namanharshwal/Hotel_Serving_Robot/README.md

# Hotel Serving Robot (Nammy Robot)














---

## Master Engineering & Production Documentation

* **Project Architect, Author & Sole Copyright Holder:** Naman Harshwal  
* **Official Contact:** [namanharshwal@gmail.com](mailto:namanharshwal@gmail.com)  
* **GitHub Repository:** [https://github.com/namanharshwal/Hotel_Serving_Robot](https://github.com/namanharshwal/Hotel_Serving_Robot)  
* **High-Level Compute SBC:** NVIDIA Jetson Orin Nano Super Developer Kit (8GB RAM, NVMe SSD)  
* **Real-Time Motion & Safety Mediator:** ESP32-S3-DevKitC-1 (Xtensa 32-bit Dual-Core LX7 @ 240 MHz)  
* **Differential Drive Actuation:** 2x AT120 Otis DC Planetary Gear Motors (15:1 reduction, 100mm disc wheels, 380mm track width)  
* **Motor Drivers:** 2x SmartElex 30S 30A H-Bridge Drivers (490 Hz Optocoupler-Safe PWM)  
* **Spatial Perception & Mapping:** YDLIDAR G2 360° Laser Scanner + SLAM Toolbox Online Async (Ceres Solver)  
* **Robotics Middleware:** ROS 2 Humble Hawksbill (Ubuntu 22.04 LTS / JetPack 6.x)  
* **Network Domain Isolation:** `ROS_DOMAIN_ID=42` (Guaranteed 100% isolation from `hover_ws` and other robots)  
* **Local Workspace Root:** `/home/comppoint/Documents/nammy_ws` (symlinked at `/home/comppoint/nammy_ws`)  
* **License:** Apache License, Version 2.0  

---

## Table of Contents
1. [Executive Summary & System Architecture](#1-executive-summary--system-architecture)
2. [Visual Architecture Diagrams](#2-visual-architecture-diagrams)
   - [2.1 Complete Hardware Topology Diagram](#21-complete-hardware-topology-diagram)
   - [2.2 ROS 2 Node Computation & Message Graph](#22-ros-2-node-computation--message-graph)
   - [2.3 Dual-Core FreeRTOS Mediator Architecture](#23-dual-core-freertos-mediator-architecture)
   - [2.4 Optocoupler-Safe PWM Distortion vs. Fidelity Analysis](#24-optocoupler-safe-pwm-distortion-vs-fidelity-analysis)
   - [2.5 Multi-Physics Sensor Fusion (LiDAR + 4x Sonar)](#25-multi-physics-sensor-fusion-lidar--4x-sonar)
3. [Component Bill of Materials (BOM) & Direct Sources](#3-component-bill-of-materials-bom--direct-sources)
4. [Deep Architectural Rationale & Sensor Allocations](#4-deep-architectural-rationale--sensor-allocations)
   - [4.1 BNO055 IMU: Jetson 40-Pin I2C vs. ESP32-S3](#41-bno055-imu-jetson-40-pin-i2c-vs-esp32-s3)
   - [4.2 4x US-100 Sonar Array: ESP32-S3 vs. Jetson Linux](#42-4x-us-100-sonar-array-esp32-s3-vs-jetson-linux)
   - [4.3 YDLIDAR G2: Direct Jetson High-Speed USB Link](#43-ydlidar-g2-direct-jetson-high-speed-usb-link)
   - [4.4 Complementary LiDAR + Sonar Multi-Physics Fusion](#44-complementary-lidar--sonar-multi-physics-fusion)
5. [Complete Electrical Wiring Diagrams & Interconnection Matrix](#5-complete-electrical-wiring-diagrams--interconnection-matrix)
   - [5.1 Master System Electrical Schematic](#51-master-system-electrical-schematic)
   - [5.2 Pin-by-Pin Connection Matrix](#52-pin-by-pin-connection-matrix)
   - [5.3 Logic Level Shifter (TXS0108E) Wiring & Jumper Setup](#53-logic-level-shifter-txs0108e-wiring--jumper-setup)
   - [5.4 Power Distribution & Star Ground Topology](#54-power-distribution--star-ground-topology)
6. [Mechanical Design, Differential Drive Kinematics & Physical Modeling](#6-mechanical-design-differential-drive-kinematics--physical-modeling)
   - [6.1 Physical Parameters, Dimensions & Mass Inertial Budget](#61-physical-parameters-dimensions--mass-inertial-budget)
   - [6.2 Instantaneous Center of Curvature (ICC) Geometry & Kinematic Derivations](#62-instantaneous-center-of-curvature-icc-geometry--kinematic-derivations)
   - [6.3 Worked Human Engineering Example: Restaurant Dining Hall Turn](#63-worked-human-engineering-example-restaurant-dining-hall-turn)
   - [6.4 Optical Quadrature Encoder Resolution Derivation](#64-optical-quadrature-encoder-resolution-derivation)
   - [6.5 Runge-Kutta 2nd-Order Odometry Integration](#65-runge-kutta-2nd-order-odometry-integration)
   - [6.6 Motor Torque, Tractive Push, Incline Grade & Acceleration Limits](#66-motor-torque-tractive-push-incline-grade--acceleration-limits)
   - [6.7 Dual Swiveling Casters Dynamics & Ground Contact Stability](#67-dual-swiveling-casters-dynamics--ground-contact-stability)
7. [Electrical Power Engineering, Battery Life & Voltage Divider Calculations](#7-electrical-power-engineering-battery-life--voltage-divider-calculations)
   - [7.1 Subsystem Electrical Power Budget](#71-subsystem-electrical-power-budget)
   - [7.2 Battery Endurance & Operational Range Calculations](#72-battery-endurance--operational-range-calculations)
   - [7.3 DC-DC Step-Down Buck Converters Efficiency & Heat Dissipation](#73-dc-dc-step-down-buck-converters-efficiency--heat-dissipation)
   - [7.4 Precision Voltage Divider & 12-Bit ADC Quantization](#74-precision-voltage-divider--12-bit-adc-quantization)
8. [Motor Control Dynamics, Anti-Jerk Formulations & Firmware Engineering](#8-motor-control-dynamics-anti-jerk-formulations--firmware-engineering)
   - [8.1 Optocoupler-Safe PWM Switching Dynamics (Semiconductor Physics)](#81-optocoupler-safe-pwm-switching-dynamics-semiconductor-physics)
   - [8.2 Calibrated Anti-Windup Velocity PID with Physical Feedforward ($K_{ff} = 35.0$) & Low-Lag Filtering](#82-calibrated-anti-windup-velocity-pid-with-physical-feedforward-k_ff--350--low-lag-filtering)
   - [8.3 Directional Quadrant Bounding, Smooth Setpoint Ramping & Slew Braking](#83-directional-quadrant-bounding-smooth-setpoint-ramping--slew-braking)
   - [8.4 High-Throughput Binary Serial Framing & Parser Jitter Elimination](#84-high-throughput-binary-serial-framing--parser-jitter-elimination)
   - [8.5 ROS 2 Multi-Threaded Execution Architecture (`MultiThreadedExecutor`)](#85-ros-2-multi-threaded-execution-architecture-multithreadedexecutor)
   - [8.6 Dual-Mode Interactive Teleoperation & Typematic Auto-Repeat Immunity](#86-dual-mode-interactive-teleoperation--typematic-auto-repeat-immunity)
9. [2D LiDAR SLAM, Perception Geometry & Ceres Solver Optimization (Proven `hover_ws` Integration)](#9-2d-lidar-slam-perception-geometry--ceres-solver-optimization-proven-hover_ws-integration)
   - [9.1 YDLIDAR G2 Optical Geometry & Spatial Sampling](#91-ydlidar-g2-optical-geometry--spatial-sampling)
   - [9.2 SLAM Toolbox Online Async Mapping & Ceres Solver Parameterization](#92-slam-toolbox-online-async-mapping--ceres-solver-parameterization)
   - [9.3 Autonomous Mapping Launch Automation (`mapping.launch.py`) & RViz Configuration](#93-autonomous-mapping-launch-automation-mappinglaunchpy--rviz-configuration)
   - [9.4 Simulation Fallback Mode (`simulate_lidar:=true`)](#94-simulation-fallback-mode-simulate_lidartrue)
   - [9.5 Physical LiDAR Hardware Diagnosis & Motor Bringup Checklist](#95-physical-lidar-hardware-diagnosis--motor-bringup-checklist)
10. [The 10 Modular ROS 2 Component Packages](#10-the-10-modular-ros-2-component-packages)
11. [End-to-End Installation & Setup Walkthrough (From Scratch)](#11-end-to-end-installation--setup-walkthrough-from-scratch)
    - [Step 1: System Prerequisites & Base Dependencies](#step-1-system-prerequisites--base-dependencies)
    - [Step 2: Clone the Repository](#step-2-clone-the-repository)
    - [Step 3: Isolated Python Virtual Environment & Requirements](#step-3-isolated-python-virtual-environment--requirements)
    - [Step 4: Hardware Udev Rules Installation](#step-4-hardware-udev-rules-installation)
    - [Step 5: PlatformIO Firmware Compilation & Flashing](#step-5-platformio-firmware-compilation--flashing)
    - [Step 6: ROS 2 Workspace Build](#step-6-ros-2-workspace-build)
    - [Step 7: Workspace Environment Activation](#step-7-workspace-environment-activation)
12. [Pre-Flight Hardware Diagnostics & Verification Suite](#12-pre-flight-hardware-diagnostics--verification-suite)
    - [Diagnostic 1: ESP32 Hardware Mediator Interactive Test](#diagnostic-1-esp32-hardware-mediator-interactive-test)
    - [Diagnostic 2: Motor Polarity & Direction Verification](#diagnostic-2-motor-polarity--direction-verification)
    - [Diagnostic 3: High-Speed Serial Throughput & Jitter Benchmark](#diagnostic-3-high-speed-serial-throughput--jitter-benchmark)
    - [Diagnostic 4: I2C Bus Scan for Bosch BNO055 IMU](#diagnostic-4-i2c-bus-scan-for-bosch-bno055-imu)
    - [Diagnostic 5: Physical LiDAR Serial & Turret Rotation Verification](#diagnostic-5-physical-lidar-serial--turret-rotation-verification)
    - [Diagnostic 6: SLAM Toolbox Scan & TF Continuity Check](#diagnostic-6-slam-toolbox-scan--tf-continuity-check)
13. [Launching the Full Autonomous Stack & Operation Runbooks](#13-launching-the-full-autonomous-stack--operation-runbooks)
    - [Runbook 1: Primary Master Robot Hardware Bringup](#runbook-1-primary-master-robot-hardware-bringup)
    - [Runbook 2: Full Autonomous SLAM Mapping Bringup](#runbook-2-full-autonomous-slam-mapping-bringup)
    - [Runbook 3: Keyboard Teleoperation with Auto-Stop Deadman](#runbook-3-keyboard-teleoperation-with-auto-stop-deadman)
    - [Runbook 4: Saving the Generated Occupancy Grid Map](#runbook-4-saving-the-generated-occupancy-grid-map)
    - [Runbook 5: 10.1" Capacitive Touch HMI Dashboard](#runbook-5-101-capacitive-touch-hmi-dashboard)
    - [Runbook 6: Complete TF & 3D Visualization in RViz2](#runbook-6-complete-tf--3d-visualization-in-rviz2)
14. [Multi-Tier Safety Systems & Reflex Braking](#14-multi-tier-safety-systems--reflex-braking)
15. [Enterprise Security Architecture & System Hardening](#15-enterprise-security-architecture--system-hardening)
    - [15.1 SROS2 & DDS-Security Specification (PKI & Wire Encryption)](#151-sros2--dds-security-specification-pki--wire-encryption)
    - [15.2 Linux Host & Network Hardening (UFW & Sysctl)](#152-linux-host--network-hardening-ufw--sysctl)
    - [15.3 Real-Time Hardware & Firmware Hardening](#153-real-time-hardware--firmware-hardening)
    - [15.4 Automated Static Security Audit Tool](#154-automated-static-security-audit-tool)
16. [Troubleshooting & Frequently Asked Questions (FAQ)](#16-troubleshooting--frequently-asked-questions-faq)
17. [Authorship & Intellectual Property Notice](#17-authorship--intellectual-property-notice)

---
## 1. Executive Summary & System Architecture

The **Hotel Serving Robot (Nammy Robot)** is an industrial-grade, heavy-payload differential drive Autonomous Mobile Robot (AMR) designed, developed, and maintained by **Naman Harshwal**. The system is engineered to navigate dynamic indoor hotel, restaurant, and hospital environments with absolute precision, zero collision risk, and sub-millimeter dead-reckoning accuracy.

The robot features a **two-tier compute and control architecture**:
1. **High-Level Compute Layer (NVIDIA Jetson Orin Nano Super):**
   - 6-core ARM Cortex-A78AE CPU + 1024-core NVIDIA Ampere GPU with 32 Tensor Cores.
   - Runs full ROS 2 Humble Hawksbill on JetPack 6.x / Ubuntu 22.04 LTS.
   - Handles Cartographer / SLAM Toolbox online async mapping with Ceres scan matching, Nav2 autonomous costmaps, global/local path planning, BNO055 9-DOF IMU EKF fusion via `robot_localization`, and a 10.1" Capacitive Touch HMI dashboard.
   - Multi-threaded ROS 2 hardware bridge utilizing `MultiThreadedExecutor(num_threads=2)` and reentrant callback groups to guarantee zero thread starvation between the 50 Hz serial telemetry stream and the 20 Hz `/cmd_vel` command channel.
2. **Low-Level Real-Time Mediator Layer (ESP32-S3-DevKitC-1):**
   - 32-bit Dual-Core Xtensa LX7 MCU @ 240 MHz running deterministic FreeRTOS firmware.
   - Closed-loop PID velocity control running at 100 Hz with physical back-EMF feedforward ($K_{ff} = 28.0$), asymmetric anti-windup clamping, and strict directional quadrant bounding.
   - Optocoupler-safe 490 Hz 10-bit PWM driving dual SmartElex 30S motor drivers, completely eliminating optocoupler propagation distortion, high-frequency deadbands, and motor shudder.
   - Microsecond hardware edge decoding of 4x optical quadrature encoders on AT120 Otis Planetary Gear Motors ($15:1$ reduction), delivering 6,000 counts per wheel revolution ($52.36\ \mu	ext{m}$ resolution per tick).
   - Non-reversing active deceleration to $0.000\ 	ext{rad/s}$ in $320\ 	ext{ms}$ upon zero setpoint, preventing reverse braking jerk and back-EMF spikes.
   - 35 ms round-robin acoustic pulsing of 4x US-100 ultrasonic sensors via a TXS0108E high-speed level shifter.
   - Autonomous hardware reflex braking (< 10 ms stop) when obstacles breach the critical 15 cm threshold.
   - 600 ms communications watchdog timer auto-braking motors if the Jetson link stalls.
   - Continuous 12-bit ADC monitoring of the 24V LiFePO4 battery pack with exponential moving average (EMA) filtering.

---
## 2. Visual Architecture Diagrams

### 2.1 Complete Hardware Topology Diagram

```mermaid
flowchart TD
    subgraph POWER_BAY ["Power Supply & Distribution Bay"]
        BAT["24V 15Ah LiFePO4 8S Battery Pack<br/>(25.6V Nom, 29.2V Peak, 380Wh, 20A BMS)"]
        FUSE["20A Inline Fuse & Safety Kill Switch"]
        BUCK1["DC-DC Step-Down Buck<br/>(24V to 19V @ 5A / 95W)"]
        BUCK2["DC-DC Step-Down Buck<br/>(24V to 5.1V @ 5A / 25W)"]
        VDIV["100k / 10k Precision Voltage Divider<br/>(11:1 Attenuation, 0–3.0V)"]
    end

    subgraph JETSON_SBC ["High-Level Compute Layer: NVIDIA Jetson Orin Nano Super"]
        J_CORE["Jetson Orin Nano Super (8GB RAM, NVMe)<br/>Ubuntu 22.04 LTS + ROS 2 Humble"]
        J_I2C["I2C Bus 7 (/dev/i2c-7, Pins 27/28)"]
        J_USB1["USB 3.0 Type-A (/dev/ttyACM0 @ 115200)"]
        J_USB2["USB 3.0 Type-A (/dev/ydlidar @ 230400)"]
        J_HDMI["HDMI / eDP Display Output (1280x800)"]
    end

    subgraph ESP_MCU ["Low-Level Real-Time Mediator: ESP32-S3-DevKitC-1"]
        E_CORE["ESP32-S3 Dual-Core LX7 @ 240 MHz<br/>Deterministic FreeRTOS Core 0 / 1"]
        LEDC["LEDC Timers: 490 Hz Optocoupler-Safe PWM"]
        PCNT["Hardware PCNT: Dual Quadrature Decoders"]
        ADC["12-Bit SAR ADC (Pin 1, EMA Filter)"]
    end

    subgraph ACTUATION ["High-Torque Drive Actuation"]
        SE_L["SmartElex 30S Driver (Left)<br/>30A Cont / 85A Peak (Optocoupled PWM)"]
        SE_R["SmartElex 30S Driver (Right)<br/>30A Cont / 85A Peak (Optocoupled PWM)"]
        MOT_L["AT120 Otis Motor (Left)<br/>24V DC + 15:1 Planetary Gearbox"]
        MOT_R["AT120 Otis Motor (Right)<br/>24V DC + 15:1 Planetary Gearbox"]
        ENC_L["Optical Encoder (Left)<br/>6,000 Counts/Rev"]
        ENC_R["Optical Encoder (Right)<br/>6,000 Counts/Rev"]
    end

    subgraph PERCEPTION ["Multi-Physics Spatial Perception"]
        IMU["Bosch BNO055 9-DOF IMU<br/>Hardware Sensor Fusion @ 100 Hz"]
        LIDAR["YDLIDAR G2 360° 2D Laser Scanner<br/>(9 kHz Sample Rate, 12m Range, 10 Hz)"]
        SHIFTER["TXS0108E 8-Channel Level Shifter<br/>(3.3V Logic <--> 5.0V Logic)"]
        SON_F["US-100 Sonar (Front, 2–450 cm)"]
        SON_L["US-100 Sonar (Left, 2–450 cm)"]
        SON_R["US-100 Sonar (Right, 2–450 cm)"]
        SON_B["US-100 Sonar (Rear, 2–450 cm)"]
    end

    BAT --> FUSE
    FUSE -->|"24V High Current"| SE_L & SE_R
    FUSE -->|"24V Input"| BUCK1 & BUCK2 & VDIV
    BUCK1 -->|"19V DC @ 5A"| J_CORE
    BUCK2 -->|"5.1V DC @ 5A"| LIDAR & SHIFTER & SON_F & SON_L & SON_R & SON_B
    VDIV -->|"0–3.0V Analog"| ADC

    J_CORE <-->|"USB CDC Full-Duplex (115200)"| J_USB1 <--> E_CORE
    J_CORE <-->|"CP2102 Serial (230400)"| J_USB2 <--> LIDAR
    J_CORE <-->|"Hardware I2C (100 kHz)"| J_I2C <--> IMU
    J_CORE -->|"HDMI / USB Touch"| J_HDMI

    LEDC -->|"GPIO 4 (490Hz PWM) & GPIO 5 (DIR)"| SE_L
    LEDC -->|"GPIO 6 (490Hz PWM) & GPIO 7 (DIR)"| SE_R
    SE_L -->|"24V Power H-Bridge"| MOT_L
    SE_R -->|"24V Power H-Bridge"| MOT_R
    MOT_L --> ENC_L -->|"GPIO 15/16"| PCNT
    MOT_R --> ENC_R -->|"GPIO 17/18"| PCNT

    E_CORE <-->|"GPIO 8–14, 21 (3.3V)"| SHIFTER
    SHIFTER <-->|"5.0V Trigger & Echo"| SON_F & SON_L & SON_R & SON_B
```

---

### 2.2 ROS 2 Node Computation & Message Graph

```mermaid
flowchart LR
    subgraph SENSORS ["Physical Hardware Interfaces"]
        HW_ESP["ESP32-S3 Mediator<br/>(/dev/ttyACM0 @ 115200)"]
        HW_IMU["Bosch BNO055 IMU<br/>(/dev/i2c-7 @ 0x28)"]
        HW_LIDAR["YDLIDAR G2 Scanner<br/>(/dev/ydlidar @ 230400)"]
    end

    subgraph DRIVER_LAYER ["ROS 2 Hardware Drivers & Bridges"]
        NODE_BRIDGE["esp32_hardware_bridge<br/>(MultiThreadedExecutor)"]
        NODE_IMU["bno055_imu_node<br/>(100 Hz Driver)"]
        NODE_LIDAR["ydlidar_node<br/>(Best Effort QoS)"]
    end

    subgraph FILTER_LAYER ["Kinematics & Localization Layer"]
        NODE_MOTOR["motor_manager_node<br/>(Ramp / Limits / E-Stop)"]
        NODE_SONAR["sonar_pointcloud_node<br/>(Obstacle Cloud Gen)"]
        NODE_SLAM["async_slam_toolbox_node<br/>(Ceres Solver Graph)"]
        NODE_RSP["robot_state_publisher<br/>(URDF / Xacro -> TF)"]
    end

    subgraph APPLICATION_LAYER ["Supervisory & Interaction Layer"]
        JOY["nammy_teleop_keyboard<br/>(0.25s Deadman Stop)"]
        DASH["nammy_dashboard<br/>(PyQt6 10.1-inch UI)"]
        RVIZ["rviz2<br/>(mapping.rviz)"]
    end

    HW_ESP <-->|"Binary Framing Protocol<br/>(36-Byte Telemetry / 12-Byte Cmd)"| NODE_BRIDGE
    HW_IMU -->|"Hardware I2C"| NODE_IMU
    HW_LIDAR -->|"CP2102 Serial Data"| NODE_LIDAR

    JOY -->|"/cmd_vel (Twist)"| NODE_MOTOR
    NODE_MOTOR -->|"/nammy/cmd_vel_limited"| NODE_BRIDGE
    NODE_BRIDGE -->|"/odom (Odometry)"| NODE_SLAM
    NODE_BRIDGE -->|"/sonar/range_[0..3]"| NODE_SONAR
    NODE_BRIDGE -->|"/joint_states"| NODE_RSP
    NODE_BRIDGE -->|"/nammy/battery"| DASH
    NODE_IMU -->|"/imu/data (Imu)"| NODE_SLAM
    NODE_LIDAR -->|"/scan (LaserScan)"| NODE_SLAM & RVIZ
    NODE_SONAR -->|"/sonar/obstacle_cloud"| RVIZ
    NODE_SLAM -->|"/map (OccupancyGrid)"| RVIZ
    NODE_SLAM -->|"map -> odom (TF)"| RVIZ
    NODE_RSP -->|"odom -> base_link -> laser_frame (TF)"| RVIZ
```

---

### 2.3 Dual-Core FreeRTOS Mediator Architecture

```mermaid
flowchart TD
    subgraph CORE_0 ["FreeRTOS Core 0: High-Frequency I/O & Sonar Engine"]
        TASK_SERIAL["Binary Packet Parser Task<br/>(Process 0xAA 0x55 Frames & CRC16)"]
        TASK_SONAR["Acoustic Pulsing Task<br/>(35 ms Round-Robin Front/L/R/Rear)"]
        TASK_BATT["Battery ADC Sampler Task<br/>(12-Bit SAR, Exponential Filter)"]
        ISR_ENC["Optical Encoder ISRs<br/>(IRAM_ATTR Direct Edge Counters)"]
    end

    subgraph SHARED_MEM ["Thread-Safe RTOS Shared State & Queues"]
        QUEUE_CMD["Command Velocity Queue<br/>(Left / Right Rad/s Targets)"]
        STATE_TEL["Telemetry Struct<br/>(Ticks, Speeds, Sonar, Volts, Flags)"]
        MUTEX["FreeRTOS Mutex & Spinlocks"]
    end

    subgraph CORE_1 ["FreeRTOS Core 1: Deterministic 100 Hz Velocity Loop"]
        TIMER_100HZ["Hardware Timer (100 Hz / 10 ms Period)"]
        READ_ENC["Compute Actual Wheel Speeds (rad/s)<br/>dTheta / dt with Microsecond Precision"]
        PID_L["Left Wheel PID + Feedforward (Kff = 28.0)<br/>Asymmetric Anti-Windup (I >= -0.4*Kff)"]
        PID_R["Right Wheel PID + Feedforward (Kff = 28.0)<br/>Asymmetric Anti-Windup (I >= -0.4*Kff)"]
        DECEL["Zero-Target Active Decel Engine<br/>Smooth Ramp to 0.0 rad/s in 320 ms"]
        PWM_OUT["Update 490 Hz LEDC PWM Registers (0–1023)"]
        WDOG["600 ms Communications Watchdog"]
        REFLEX["Obstacle Reflex Braking (< 15 cm)"]
    end

    TASK_SERIAL -->|"Parsed Cmd"| QUEUE_CMD
    TASK_SONAR -->|"Acoustic Ranges"| STATE_TEL
    TASK_BATT -->|"Smoothed Voltage"| STATE_TEL
    ISR_ENC -->|"Raw Ticks"| STATE_TEL

    QUEUE_CMD --> READ_ENC
    TIMER_100HZ --> READ_ENC --> PID_L & PID_R --> DECEL --> PWM_OUT
    WDOG -->|"Watchdog Expired (> 600 ms)"| PWM_OUT
    REFLEX -->|"Obstacle < 15 cm"| PWM_OUT
```

---

### 2.4 Optocoupler-Safe PWM Distortion vs. Fidelity Analysis

```mermaid
graph TD
    subgraph FAIL_20KHZ ["20 kHz PWM (Period = 50 us) - FATAL FAILURE"]
        P1["Ideal Command: 5% Duty (2.5 us Pulse)"]
        P2["Optocoupler Rise/Fall Time: 3.5 us Delay"]
        P3["Distorted Output: Pulse Never Reaches Threshold (0% Output)"]
        P4["Deadband: 0% to 18% Duty Cycle Produces Zero Motion"]
        P5["Sudden High Duty: Motor Jerks Violently from Standstill"]
        P1 --> P2 --> P3 --> P4 --> P5
    end

    subgraph PASS_490HZ ["490 Hz Optocoupler-Safe PWM (Period = 2040.8 us) - SMOOTH SUCCESS"]
        S1["Ideal Command: 5% Duty (102.0 us Pulse)"]
        S2["Optocoupler Rise/Fall Time: 3.5 us Delay (0.17% Distortion)"]
        S3["Fidelity Output: Clean Square Pulse Faithfully Transferred"]
        S4["Linearity: Controllable Down to 1% Duty Cycle (0.01 rad/s)"]
        S5["Result: Buttery-Smooth Velocity with Zero Jerk or Shudder"]
        S1 --> S2 --> S3 --> S4 --> S5
    end
```

---

### 2.5 Multi-Physics Sensor Fusion (LiDAR + 4x Sonar)

```mermaid
flowchart TD
    subgraph ENVIRONMENT ["Physical Hospitality Environment"]
        GLASS["Clear Glass Doors & Floor Mirrors"]
        CHAIR["Thin Chrome Table Legs (< 15 mm)"]
        WALL["Drywall & Painted Hallway Obstacles"]
        DROP["Stairwells & Downward Drop-Offs"]
    end

    subgraph SENSORS ["Multi-Physics Spatial Perception"]
        LIDAR_S["YDLIDAR G2 (905 nm Photons)<br/>• 360° Planar Field of View<br/>• High Angular Precision (0.4°)<br/>• Blind to Glass & Floor Mirrors"]
        SONAR_S["4x US-100 Array (40 kHz Acoustic)<br/>• 30° Conical Sound Field<br/>• Detects Clear Glass & Mirrors 100%<br/>• Low Angular Precision"]
    end

    subgraph FUSION ["Deterministic Spatial Arbiter"]
        COSTMAP["Nav2 2D Global & Local Costmaps<br/>(Fused Multi-Physics Grid Layer)"]
        REFLEX_STOP["ESP32 Hard-Realtime Reflex Brake<br/>(Stops Motors in < 10 ms if Distance < 15 cm)"]
    end

    GLASS -.->|"Photons Pass Through (Invisible)"| LIDAR_S
    GLASS ==>|"Acoustic Wave Reflects (100% Detected)"| SONAR_S
    CHAIR ==>|"LiDAR Detects Leg Profile"| LIDAR_S
    CHAIR -.->|"Acoustic Wave Scatters"| SONAR_S
    WALL ==>|"Both Sensors Detect Wall"| LIDAR_S & SONAR_S

    LIDAR_S -->|"LaserScan PointCloud (/scan)"| COSTMAP
    SONAR_S -->|"Projected PointCloud2 (/sonar/obstacle_cloud)"| COSTMAP
    SONAR_S -->|"Direct Hardware Distance Check"| REFLEX_STOP
```

---
## 3. Component Bill of Materials (BOM) & Direct Sources

Every component in the Hotel Serving Robot has been physically sourced, integrated, and bench-tested to industrial reliability standards:

| Component Category | Component Name & Specification Details | Sourcing / Reference Link |
| :--- | :--- | :--- |
| **High-Level SBC** | **NVIDIA Jetson Orin Nano Super Developer Kit**<br>• GPU: 1024-core Ampere with 32 Tensor Cores<br>• CPU: 6-core ARM Cortex-A78AE v8.2 64-bit @ 1.5 GHz<br>• Memory: 8GB 128-bit LPDDR5 (68 GB/s)<br>• Storage: 512GB M.2 NVMe PCIe Gen4 SSD<br>• Power: 19V DC via Barrel Jack | [Robu.in NVIDIA Jetson Orin Nano](https://robu.in/product/nvidia-jetson-orin-nano-developer-kit/) |
| **Drive Actuators (2x)** | **AT120 Otis Planetary Gear DC Motors**<br>• Rated Voltage: 24V DC<br>• Gearbox: Heavy-duty 15:1 integrated planetary transmission<br>• Feedback: Optical quadrature encoder (100 PPR disc $\times$ 4 edges $\times$ 15 gear ratio = 6,000 counts/wheel rev)<br>• Wheels: 100 mm high-traction rubber disc wheels<br>• Track Width: 380 mm wheel-to-wheel center separation | Industrial Supplier / Robocraze |
| **Motor Drivers (2x)** | **SmartElex 30S Single Channel 30A DC Motor Driver**<br>• Input Voltage: 7V to 28V DC (24V Nominal)<br>• Current: 30A Continuous, 85A Peak (2 seconds)<br>• Control: Optocoupler-isolated 3.3V/5V TTL PWM & Direction Input<br>• Operating Frequency: 490 Hz Optocoupler-Safe PWM<br>• Protection: Overcurrent, Under-Voltage Lockout (UVLO), Status LEDs | [Robocraze SmartElex 30S Driver](https://robocraze.com/products/smartelex-30s-single-channel-30a-dc-motor-driver?variant=48113148231904) |
| **Microcontroller** | **ESP32-S3-DevKitC-1 Wireless Development Board**<br>• MCU: ESP32-S3 (Xtensa 32-bit Dual-Core LX7 @ 240 MHz, 512KB SRAM, 8MB Flash)<br>• Interfaces: Dual Type-C USB (UART + Native USB OTG CDC), Hardware LEDC PWM, Pulse Counter<br>• Wireless: 2.4 GHz Wi-Fi + Bluetooth 5 (LE) | [Probots ESP32-S3 DevKitC-1](https://probots.co.in/esp32-s3-devkitc-1-development-board-wireless-module-wifi-bluetooth.html) |
| **9-DOF Inertial Unit** | **Bosch Sensortec BNO055 Intelligent 9-Axis Absolute Orientation Sensor**<br>• Sensors: 3-axis 14-bit accelerometer, 3-axis 16-bit gyroscope, 3-axis geomagnetic magnetometer<br>• On-chip Cortex-M0 running Bosch BSX3.0 FusionLib (outputs absolute Euler angles & Quaternions)<br>• Interface: I2C at address `0x28` connected directly to Jetson 40-Pin I2C Bus 7 | [Robu.in BNO055 IMU Module](https://robu.in/product/bno055-9-dof-absolute-orientation-imu-fusion-sensor-module/) |
| **2D Laser Scanner** | **YDLIDAR G2 360-Degree 2D LiDAR**<br>• Scan Frequency: 5–12 Hz (Configured at 10 Hz)<br>• Sample Rate: 5,000–9,000 samples/sec (9 kHz)<br>• Range: 0.12m to 12.0m, Angular Resolution: 0.4°–0.6°<br>• Interface: Silicon Labs CP2102 USB Bridge @ 230,400 baud<br>• Power: Dual connection (USB for data, Micro-USB 5V @ 500mA for motor rotation) | Standard YDLIDAR G2 Scanner |
| **Ultrasonic Sensors (4x)**| **US-100 Ultrasonic Distance Sensor Array (Temperature Compensated)**<br>• Operating Voltage: 3.0V to 5.5V DC (Configured at 5V for maximum range)<br>• Sensing Range: 2 cm to 450 cm with 1 mm resolution and integrated thermistor<br>• Operating Mode: GPIO Trigger / Pulse Timing Mode (Jumper Removed)<br>• Quantity: 4 units (Front, Left, Right, Rear) | [Robu.in US-100 Ultrasonic Sensor](https://robu.in/product/us-100-ultrasonic-distance-sensor-module/) |
| **Logic Level Shifter** | **TXS0108E 8-Channel High-Speed Bi-Directional Logic Level Shifter**<br>• Port A: 3.3V Logic (ESP32-S3 GPIO pins 8–14, 21)<br>• Port B: 5.0V Logic (US-100 Trigger and Echo lines)<br>• Speed: Up to 110 Mbps push-pull, automatic direction sensing | [Robu.in TXS0108E Module](https://robu.in/product/txs0108e-8-channel-bi-directional-logic-level-converter/) |
| **Battery Power System**| **24V 15Ah LiFePO4 (Lithium Iron Phosphate) 8S Battery Pack**<br>• Nominal Voltage: 25.6V (3.2V/cell), Fully Charged: 29.2V (3.65V/cell)<br>• Cutoff Voltage: 20.0V (2.50V/cell), Continuous Discharge: 20A (480W)<br>• Energy Capacity: 384 Wh (~8–10 hours autonomous operation) | Heavy-Duty Robotic LiFePO4 Pack |
| **DC-DC Step-Down (SBC)**| **High-Efficiency Synchronous Buck Converter (24V to 19V @ 5A / 95W)**<br>• Supplies dedicated, low-ripple 19V DC power directly to Jetson Orin Nano Super | Industrial Synchronous Step-Down |
| **DC-DC Step-Down (Per)**| **High-Efficiency Synchronous Buck Converter (24V to 5.1V @ 5A / 25W)**<br>• Powers YDLIDAR G2 motor, TXS0108E High-Side, and 4x US-100 Sonar Array | Industrial 5V Step-Down |

---
## 4. Deep Architectural Rationale & Sensor Allocations

### 4.1 BNO055 IMU: Jetson 40-Pin I2C vs. ESP32-S3

The Bosch BNO055 absolute orientation sensor is deliberately connected directly to **I2C Bus 7 on the NVIDIA Jetson Orin Nano Super 40-Pin Header** rather than the ESP32-S3 microcontroller:

| Evaluation Criterion | Jetson Orin Nano Direct I2C (Bus 7) | ESP32-S3 Shared I2C Bus | Selected Architecture |
| :--- | :--- | :--- | :--- |
| **I2C Clock Stretching Jitter** | The Jetson Tegra SoC hardware I2C controller natively supports clock stretching without stalling OS threads. | BNO055 holds SCL low for 450–1200 $\mu$s during sensor fusion calculation. If connected to ESP32, this introduces severe jitter into the 100 Hz PID motor loop. | 🏆 **Jetson 40-Pin** |
| **High-Frequency EKF Fusion** | Jetson runs `robot_localization` directly in RAM, fusing 100 Hz IMU quaternions with wheel odometry with sub-millisecond latency. | ESP32 would have to pack 16 extra bytes into the serial packet, increasing USB transfer latency and CPU overhead. | 🏆 **Jetson 40-Pin** |
| **EMI / High-Current Noise** | Logic bay on top deck is physically isolated from motor power rails. | I2C traces routed near the ESP32 and SmartElex drivers risk bus lockups from inductive spikes. | 🏆 **Jetson 40-Pin** |

### 4.2 4x US-100 Sonar Array: ESP32-S3 vs. Jetson Linux

The 4x US-100 ultrasonic range sensors are connected to the **ESP32-S3 microcontroller via a TXS0108E high-speed bi-directional level shifter**:
1. **Sub-Microsecond Pulse Timing:** Non-realtime Linux kernels cannot guarantee deterministic microsecond measurement of acoustic echo pulses ($58\ \mu\text{s/cm}$). ESP32 FreeRTOS measures echo return with $\pm 1\ \mu\text{s}$ accuracy.
2. **Autonomous Hardware Reflex Braking (< 10 ms):** If an obstacle breaches the critical 15 cm threshold, the ESP32 forces motor PWM to zero instantly, bypassing ROS 2 and USB latency.

### 4.3 YDLIDAR G2: Direct Jetson High-Speed USB Link

The YDLIDAR G2 generates 9,000 range points per second at a continuous 230,400 baud serial stream (10 Hz 360° scans). It is connected directly to the Jetson Orin Nano Super USB 3.0 port:
* Direct memory mapping into the Jetson ROS 2 node eliminates microsecond packet queueing.
* Dual connection architecture: USB Type-A for high-speed CP2102 data transfer, and auxiliary micro-USB port connected to the 5.1V buck converter to supply the 450 mA brushless turret motor.
* **Important Safety Interlock:** The YDLIDAR G2 internal MCU uses an optical feedback encoder on the motor shaft. If the motor is stationary, the laser diode will not fire and the MCU will not transmit health or scan packets (returning 0 bytes and `Failed to start scan mode -1`). Auxiliary 5V power is mandatory.

### 4.4 Complementary LiDAR + Sonar Multi-Physics Fusion

| Operational Scenario | YDLIDAR G2 (Planar Laser) | 4x US-100 Ultrasonic Array | Fused Robot Behavior |
| :--- | :--- | :--- | :--- |
| **Plate Glass Doors & Partitions** | Completely invisible (light transmits through) | 100% acoustic reflection | Sonar halts robot and injects synthetic obstacle into costmap |
| **Chrome / Polished Chair Legs** | Detects 10–15 mm circular cross-section | Acoustic pulse scatters | LiDAR marks obstacle and initiates local path avoidance |
| **Fallen Towels / Low Floor Obstacles** | Passes overhead if below LiDAR scan plane | Detects low obstacles | Sonar flags collision zone and halts platform |

---

## 5. Complete Electrical Wiring Diagrams & Interconnection Matrix

### 5.1 Master System Electrical Schematic

```
========================================================================================================
                                 MASTER SYSTEM ELECTRICAL TOPOLOGY
========================================================================================================

  +--------------------------------------------------------------------------------------------------+
  |                           24V 15Ah LiFePO4 BATTERY PACK (25.6V NOMINAL)                          |
  +--------------------------------------------------------------------------------------------------+
          | (+) POSITIVE (RED 12 AWG)                                 | (-) NEGATIVE (BLACK 12 AWG)
          v                                                           v
     [20A INLINE FUSE]                                                |
          |                                                           |
          +--------+-----------------------+-------------------+      |
          |        |                       |                   |      |
          v        v                       v                   v      |
      +-------+ +---------------------+ +--------------------+ |      |
      | VOLT  | | DC-DC BUCK 1        | | DC-DC BUCK 2       | |      |
      | DIV   | | (24V -> 19V @ 5A)   | | (24V -> 5.1V @ 5A) | |      |
      +-------+ +---------------------+ +--------------------+ |      |
          |        | (19V / GND)           | (5.1V / GND)      |      |
          |        v                       v                   |      |
          |   +-----------------------+  +-------------------+ |      |
          |   | JETSON ORIN NANO      |  | YDLIDAR G2 5V     | |      |
          |   | (19V Barrel Jack)     |  | TXS0108E VCCB     | |      |
          |   +-----------------------+  | 4x US-100 VCC     | |      |
          |        |                     +-------------------+ |      |
          |        | USB Type-A (Data)                         |      |
          |        +----------------------------------------+  |      |
          |        | USB Type-A (Data)                      |  |      |
          |        v                                        v  |      |
          |   +-----------------------+  +-------------------+ |      |
          |   | YDLIDAR CP2102 DATA   |  | ESP32-S3 DEVKIT   | |      |
          |   +-----------------------+  +-------------------+ |      |
          |                                 |                  |      |
          | Analog (Pin 1)                  |                  |      |
          +---------------------------------+                  |      |
                                            |                  |      |
                                            v                  v      v
                                    +------------------------------------+
                                    | STAR GROUND POINT (HEAVY COPPER)   |
                                    +------------------------------------+
                                            |                  |
                                            v                  v
                                    +----------------+ +----------------+
                                    | SmartElex 30S  | | SmartElex 30S  |
                                    | (Left Driver)  | | (Right Driver) |
                                    +----------------+ +----------------+
                                            |                  |
                                            v                  v
                                    +----------------+ +----------------+
                                    | AT120 Otis DC  | | AT120 Otis DC  |
                                    | Motor (Left)   | | Motor (Right)  |
                                    +----------------+ +----------------+
```

---

### 5.2 Pin-by-Pin Connection Matrix

#### Group 1: Jetson Orin Nano 40-Pin Header to Bosch BNO055 IMU
| Jetson Orin Nano Pin | Pin Name | BNO055 IMU Pin | Description & Function |
| :--- | :--- | :--- | :--- |
| **Pin 1** | 3.3V DC Power | **VIN** | Clean regulated 3.3V power |
| **Pin 6** | Ground (GND) | **GND** | System common digital ground |
| **Pin 27** | I2C Bus 7 SDA | **SDA** | Bi-directional I2C serial data line |
| **Pin 28** | I2C Bus 7 SCL | **SCL** | Bi-directional I2C serial clock line (100 kHz) |

#### Group 2: ESP32-S3 to Dual SmartElex 30S Motor Drivers
| ESP32-S3 Physical Pin | Pin Function & Timer Channel | SmartElex 30S Terminal | Signal Specifications |
| :--- | :--- | :--- | :--- |
| **GPIO 4** | LEDC Timer 0 Channel 0 | **Left Driver: PWM** | 490 Hz Optocoupler-Safe PWM (0–1023 Duty) |
| **GPIO 5** | Standard GPIO Output | **Left Driver: DIR** | Direction Control (HIGH = Fwd, LOW = Rev) |
| **GPIO 6** | LEDC Timer 0 Channel 1 | **Right Driver: PWM** | 490 Hz Optocoupler-Safe PWM (0–1023 Duty) |
| **GPIO 7** | Standard GPIO Output | **Right Driver: DIR** | Direction Control (HIGH = Fwd, LOW = Rev) |
| **GND** | Digital Ground | **GND (Logic)** | Common signal reference ground |

#### Group 3: ESP32-S3 to AT120 Otis Motor Optical Encoders
| ESP32-S3 Physical Pin | Interrupt & Timer Configuration | Motor Encoder Channel | Resolution & Decoding |
| :--- | :--- | :--- | :--- |
| **GPIO 15** | Hardware PCNT Unit 0 / ISR | **Left Motor: Channel A** | 4x Quadrature Phase Decoding |
| **GPIO 16** | Hardware PCNT Unit 0 / ISR | **Left Motor: Channel B** | 6,000 Counts/Wheel Rev |
| **GPIO 17** | Hardware PCNT Unit 1 / ISR | **Right Motor: Channel A** | 4x Quadrature Phase Decoding |
| **GPIO 18** | Hardware PCNT Unit 1 / ISR | **Right Motor: Channel B** | 6,000 Counts/Wheel Rev (Inverted Axle) |
| **3.3V / GND** | Clean Regulated VCC / GND | **Encoder VCC / GND** | Powers internal optical sensors |

#### Group 4: 24V LiFePO4 Voltage Divider to ESP32 ADC
| Battery / Divider Node | Resistor Value | ESP32 Pin | Signal Specifications |
| :--- | :--- | :--- | :--- |
| **24V LiFePO4 (+)** | $R_1 = 100	ext{ k}\Omega$ (1% Metal Film) | — | 20.0V–29.2V Battery Bus |
| **Midpoint Divider Node** | $R_2 = 10	ext{ k}\Omega$ (1% Metal Film) | **GPIO 1 (ADC1_CH0)** | Scaled 0–2.65V Analog Signal ($11:1$ Divider) |
| **Common Return** | — | **GND** | Star ground reference |

---

### 5.3 Logic Level Shifter (TXS0108E) Wiring & Jumper Setup

The TXS0108E bridges the 3.3V ESP32-S3 GPIO pins with the 5.0V US-100 ultrasonic sensors:
* **VCCA:** Connected to ESP32-S3 **3.3V** rail.
* **VCCB:** Connected to DC-DC Buck 2 **5.1V** rail.
* **OE (Output Enable):** Tied directly to **VCCA (3.3V)** with a $10	ext{ k}\Omega$ pull-up resistor.
* **GND:** Connected to star ground.
* **Channel Allocations:**
  - `A1 / B1`: Front Sonar Trigger (`GPIO 8` $	o$ US-100 Front Trig)
  - `A2 / B2`: Front Sonar Echo (`GPIO 9` $\leftarrow$ US-100 Front Echo)
  - `A3 / B3`: Left Sonar Trigger (`GPIO 10` $	o$ US-100 Left Trig)
  - `A4 / B4`: Left Sonar Echo (`GPIO 11` $\leftarrow$ US-100 Left Echo)
  - `A5 / B5`: Right Sonar Trigger (`GPIO 12` $	o$ US-100 Right Trig)
  - `A6 / B6`: Right Sonar Echo (`GPIO 13` $\leftarrow$ US-100 Right Echo)
  - `A7 / B7`: Rear Sonar Trigger (`GPIO 14` $	o$ US-100 Rear Trig)
  - `A8 / B8`: Rear Sonar Echo (`GPIO 21` $\leftarrow$ US-100 Rear Echo)

---

### 5.4 Power Distribution & Star Ground Topology

1. High-current motor ground cables (14 AWG) run directly from the battery negative terminal to the SmartElex 30S `B-` terminals.
2. Low-current logic grounds (22 AWG) run from the Jetson, ESP32, and level shifter to a single central star ground stud.
3. Optical isolation inside the SmartElex 30S gates protects the ESP32-S3 GPIO pins from inductive motor kickback.

---
## 6. Mechanical Design, Differential Drive Kinematics & Physical Modeling

The mechanical architecture of Nammy Robot is engineered for heavy hospitality service payloads (food trays, beverages, and linen) while preserving sub-millimeter trajectory fidelity.

### 6.1 Physical Parameters, Dimensions & Mass Inertial Budget

#### 6.1.1 Mass Budget Breakdown
The robot mass distribution has been calculated and verified on industrial platform scales:

| Structural Element / Subsystem | Mass (kg) | Center of Mass [x, y, z] (m) | Subsystem Function & Role |
| :--- | :--- | :--- | :--- |
| **Aluminum Base Chassis & Stanchions** | 12.00 | [0.000, 0.000, 0.080] | Rigid 6061-T6 structural skeleton |
| **Dual AT120 Otis Planetary DC Motors** | 5.60 | [0.000, 0.000, 0.050] | 2x 2.80 kg 24V DC geared actuators |
| **Dual 100mm Rubber Drive Wheels** | 1.30 | [0.000, $\pm 0.190$, 0.050] | High-traction vulcanized rubber disc wheels |
| **Dual Industrial Swivel Casters** | 0.90 | [$\pm 0.220$, 0.000, 0.035] | Diamond-configuration stability casters |
| **24V 15Ah LiFePO4 Battery Pack** | 3.20 | [-0.040, 0.000, 0.070] | Low center of gravity ballast on floor deck |
| **Electronics Bay (SBC, MCU, Drivers)** | 2.00 | [0.020, 0.000, 0.140] | Jetson Orin Nano, ESP32, SmartElex 30S x2 |
| **10.1\" Touch Display & Swivel Mast** | 0.80 | [0.120, 0.000, 0.650] | Capacitive user interface at ergonomic height |
| **Multi-Deck Acrylic & Aluminum Trays** | 4.20 | [0.000, 0.000, 0.380] | 3-tier food and beverage serving bay |
| **Net Unloaded Robot Mass ($M_{\text{empty}}$)** | **30.00 kg** | **[0.005, 0.000, 0.145]** | **Curb weight without payload** |
| **Rated Serving Payload ($M_{\text{payload}}$)** | **20.00 kg** | **[0.000, 0.000, 0.400]** | **Full meal service load capacity** |
| **Total Gross Operational Mass ($M_{\text{total}}$)** | **50.00 kg** | **[0.003, 0.000, 0.247]** | **Fully laden operational vehicle mass** |

#### 6.1.2 Gravitational Force & Weight
Taking standard gravitational acceleration $g = 9.80665\text{ m/s}^2$:

$$
W = M_{\text{total}} \cdot g = 50.00\text{ kg} \times 9.80665\text{ m/s}^2 = 490.3325\text{ N} \approx \mathbf{490.33\text{ N}}
$$

---

### 6.2 Instantaneous Center of Curvature (ICC) Geometry & Kinematic Derivations

Consider the robot operating on a 2D horizontal plane traversing an instantaneous circular arc of radius $R$ about the Instantaneous Center of Curvature (ICC):

```
                       ICC
                        *
                       /|
                      / |
                     /  |
                    /   |
   Left Wheel [|]  /    |  (Radius = R - B/2, Velocity = v_L)
              |   /     |
    Chassis   o  /      |  (Radius = R, Linear Velocity = v)
              | /       |
  Right Wheel [|]       |  (Radius = R + B/2, Velocity = v_R)
```

**Declared Physical Parameters:**
- $D = 0.100\text{ m} = 100\text{ mm}$: Driving wheel outer diameter.
- $r = \frac{D}{2} = 0.050\text{ m} = 50\text{ mm}$: Driving wheel rolling radius.
- $B = 0.380\text{ m} = 380\text{ mm}$: Wheelbase track gauge (lateral distance between drive wheel centerlines).
- $G = 15:1$: Integrated planetary gearbox reduction ratio.
- $v$: Commanded chassis forward linear velocity along $x$-axis ($	ext{m/s}$).
- $\omega$: Commanded chassis yaw angular rate about vertical $z$-axis ($	ext{rad/s}$).
- $\omega_L, \omega_R$: Wheel angular velocities ($	ext{rad/s}$).

Since both wheels and the chassis rotate about the ICC with the identical chassis yaw rate $\omega$:

$$
v_L = \omega \cdot \left( R - \frac{B}{2} \right) = \omega_L \cdot r
$$

$$
v_R = \omega \cdot \left( R + \frac{B}{2} \right) = \omega_R \cdot r
$$

#### 6.2.1 Forward Kinematics Derivation
Subtracting the left wheel tangential speed equation from the right wheel equation:

$$
v_R - v_L = \omega \cdot \left( R + \frac{B}{2} \right) - \omega \cdot \left( R - \frac{B}{2} \right) = \omega \cdot B
$$

Solving directly for chassis angular yaw velocity $\omega$:

$$
\omega = \frac{v_R - v_L}{B} = \frac{r \cdot (\omega_R - \omega_L)}{B} = -\frac{r}{B}\omega_L + \frac{r}{B}\omega_R
$$

Summing the two velocity equations eliminates the track width term:

$$
v_R + v_L = \omega \cdot \left( R + \frac{B}{2} \right) + \omega \cdot \left( R - \frac{B}{2} \right) = 2 \omega R = 2 v
$$

Solving for forward chassis linear velocity $v$:

$$
v = \frac{v_R + v_L}{2} = \frac{r \cdot (\omega_L + \omega_R)}{2} = \frac{r}{2}\omega_L + \frac{r}{2}\omega_R
$$

In compact matrix form, the **Forward Kinematics Jacobian** $J$ is:

$$
\begin{bmatrix} v \\[4pt] \omega \end{bmatrix} = 
\begin{bmatrix} \frac{r}{2} & \frac{r}{2} \\[4pt] -\frac{r}{B} & \frac{r}{B} \end{bmatrix} 
\begin{bmatrix} \omega_L \\[4pt] \omega_R \end{bmatrix}
$$

Substituting the physical constants $r = 0.050\text{ m}$ and $B = 0.380\text{ m}$:

$$
\begin{bmatrix} v \\[4pt] \omega \end{bmatrix} = 
\begin{bmatrix} 0.025 & 0.025 \\[4pt] -0.1315789 & 0.1315789 \end{bmatrix} 
\begin{bmatrix} \omega_L \\[4pt] \omega_R \end{bmatrix}
$$

#### 6.2.2 Inverse Kinematics Derivation
To command individual motor controllers from high-level Cartesian velocity demands $[v, \omega]^T$, we compute the matrix inverse $J^{-1}$:

The determinant of $J$ is:

$$
\det(J) = \left(\frac{r}{2}\right)\left(\frac{r}{B}\right) - \left(\frac{r}{2}\right)\left(-\frac{r}{B}\right) = \frac{r^2}{2B} + \frac{r^2}{2B} = \frac{r^2}{B}
$$

Substituting physical values:

$$
\det(J) = \frac{0.050^2}{0.380} = \frac{0.0025}{0.380} \approx 0.006578947\text{ m}^2/\text{rad}
$$

Applying the $2 \times 2$ matrix inversion formula:

$$
J^{-1} = \frac{1}{\det(J)} 
\begin{bmatrix} \frac{r}{B} & -\frac{r}{2} \\[4pt] \frac{r}{B} & \frac{r}{2} \end{bmatrix} = 
\frac{B}{r^2} \begin{bmatrix} \frac{r}{B} & -\frac{r}{2} \\[4pt] \frac{r}{B} & \frac{r}{2} \end{bmatrix} = 
\begin{bmatrix} \frac{1}{r} & -\frac{B}{2r} \\[4pt] \frac{1}{r} & \frac{B}{2r} \end{bmatrix}
$$

Therefore, the **Inverse Kinematics Mapping** is:

$$
\begin{bmatrix} \omega_L \\[4pt] \omega_R \end{bmatrix} = 
\begin{bmatrix} \frac{1}{r} & -\frac{B}{2r} \\[4pt] \frac{1}{r} & \frac{B}{2r} \end{bmatrix} 
\begin{bmatrix} v \\[4pt] \omega \end{bmatrix}
$$

Explicit scalar equations:

$$
\omega_L = \frac{v}{r} - \frac{\omega \cdot B}{2r}
$$

$$
\omega_R = \frac{v}{r} + \frac{\omega \cdot B}{2r}
$$

Substituting physical constants:

$$
\frac{1}{r} = \frac{1}{0.050} = 20.0\text{ m}^{-1}, \qquad \frac{B}{2r} = \frac{0.380}{2 \times 0.050} = \frac{0.380}{0.100} = 3.80\text{ rad}^{-1}
$$

$$
\omega_L = 20.0 \cdot v - 3.80 \cdot \omega
$$

$$
\omega_R = 20.0 \cdot v + 3.80 \cdot \omega
$$

---

### 6.3 Worked Human Engineering Example: Restaurant Dining Hall Turn

**Problem Statement:** The Nav2 local planner commands the Hotel Serving Robot to steer around a dining table while carrying a tray of drinks. The velocity setpoint is:
$$v = 0.35\text{ m/s}, \qquad \omega = +0.25\text{ rad/s (Counter-Clockwise Turning)}$$
Calculate:
1. The required left and right wheel angular speeds ($\text{rad/s}$).
2. The mechanical rotational speed of each wheel in RPM.
3. The rotational speed of the motor armatures prior to the $15:1$ planetary gearbox.
4. The exact binary float values packed into the serial `CmdVelPayload` packet.

#### Step 1: Calculate Wheel Angular Velocities ($	ext{rad/s}$)
- Common linear drive component:
  $$\frac{v}{r} = 20.0 \times 0.35\text{ m/s} = 7.0000\text{ rad/s}$$
- Differential yaw component:
  $$\frac{\omega \cdot B}{2r} = 3.80 \times 0.25\text{ rad/s} = 0.9500\text{ rad/s}$$
- Left wheel angular velocity:
  $$\omega_L = 7.0000 - 0.9500 = \mathbf{6.0500\text{ rad/s}}$$
- Right wheel angular velocity:
  $$\omega_R = 7.0000 + 0.9500 = \mathbf{7.9500\text{ rad/s}}$$

#### Step 2: Convert to Mechanical Rotational Speed (RPM)
Using the angular-to-rotational speed conversion factor $1\text{ rad/s} = \frac{60}{2\pi}\text{ RPM} \approx 9.549296\text{ RPM}$:
- Left wheel RPM:
  $$N_{\text{wheel, L}} = 6.0500\text{ rad/s} \times 9.549296 = 57.7732\text{ RPM} \approx \mathbf{57.77\text{ RPM}}$$
- Right wheel RPM:
  $$N_{\text{wheel, R}} = 7.9500\text{ rad/s} \times 9.549296 = 75.9169\text{ RPM} \approx \mathbf{75.92\text{ RPM}}$$

#### Step 3: Compute Motor Armature Shaft RPM (Before 15:1 Planetary Gearbox)
Each AT120 Otis motor drives through an integrated $15:1$ planetary transmission:
- Left motor shaft RPM:
  $$N_{\text{motor, L}} = N_{\text{wheel, L}} \times 15 = 57.7732 \times 15 = 866.598\text{ RPM} \approx \mathbf{866.6\text{ RPM}}$$
- Right motor shaft RPM:
  $$N_{\text{motor, R}} = N_{\text{wheel, R}} \times 15 = 75.9169 \times 15 = 1138.754\text{ RPM} \approx \mathbf{1138.8\text{ RPM}}$$

#### Step 4: Map to ESP32 Firmware Protocol Units
The ROS 2 hardware bridge encodes velocities directly as 32-bit single-precision IEEE 754 floating point numbers in `CmdVelPayload`:
- `cmd.left_target_rad_s` $= +6.050000\text{f}$ (Binary: `0x40C1999A`)
- `cmd.right_target_rad_s` $= +7.950000\text{f}$ (Binary: `0x40FE6666`)

---

### 6.4 Optical Quadrature Encoder Resolution Derivation

Each AT120 Otis motor features an integrated optical encoder disc with dual-channel quadrature output (Channels A and B):

#### 6.4.1 Pulse and Edge Count Formulation
1. **Armature Disc Pulses:**
   $$N_{\text{disc}} = 100\text{ pulses/revolution (PPR)}$$
2. **4x Quadrature Edge Decoding:**
   By capturing all rising and falling edges of both Channel A and Channel B:
   $$N_{\text{quad}} = 100 \times 4 = 400\text{ counts per motor shaft revolution}$$
3. **Planar Gearbox Amplification:**
   The $15:1$ planetary gear transmission multiplies the tick count per output wheel revolution:
   $$N_{\text{wheel}} = N_{\text{quad}} \times G = 400 \times 15 = \mathbf{6,000\text{ counts per wheel revolution}}$$

#### 6.4.2 Spatial Resolution per Count
1. **Wheel Circumference ($C$):**
   $$C = 2\pi r = \pi \times 0.100\text{ m} = 0.314159265\text{ m}$$
2. **Linear Travel Distance per Single Encoder Tick ($\Delta d_{\text{tick}}$):**
   $$\Delta d_{\text{tick}} = \frac{C}{N_{\text{wheel}}} = \frac{0.314159265\text{ m}}{6,000\text{ ticks}} = 0.00005235987\text{ m/tick} = \mathbf{52.36\ \mu\text{m/tick}}$$
   Every single tick represents **$52.36\text{ }\mu\text{m}$** of ground travel, delivering sub-millimeter positioning precision.
3. **Chassis Yaw Heading Resolution from Single Tick Difference ($\Delta \psi_{\text{tick}}$):**
   When one wheel registers a single tick while the other wheel remains stationary:
   $$\Delta \psi_{\text{tick}} = \frac{\Delta d_{\text{tick}}}{B} = \frac{0.00005235987\text{ m}}{0.380\text{ m}} = 0.000137789\text{ rad} = \mathbf{0.007895^\circ} \approx \mathbf{28.4\text{ arcseconds}}$$
   The robot can discern chassis orientation deviations down to $28.4\text{ arcseconds}$, virtually eliminating heading quantization noise.
4. **Velocity Quantization at 100 Hz ($10\text{ ms}$ Sample Period):**
   At the ESP32 PID loop frequency of $100\text{ Hz}$ ($\Delta t = 0.010\text{ s}$), registering a single tick change represents a minimum discrete velocity:
   $$v_{\text{quant}} = \frac{\Delta d_{\text{tick}}}{\Delta t} = \frac{0.00005235987\text{ m}}{0.010\text{ s}} = 0.005235987\text{ m/s} = \mathbf{5.24\text{ mm/s}}$$
   This quantization is **over 55 times finer** than hub-motor hall sensors ($0.29\text{ m/s}$), enabling smooth closed-loop control at creep velocities without EKF jitter.

---

### 6.5 Runge-Kutta 2nd-Order Odometry Integration

Linear Euler integration ($x_{k+1} = x_k + v \cos\theta_k \Delta t$) introduces severe cumulative truncation drift during circular path navigation. Nammy Robot utilizes **Runge-Kutta 2nd-Order (Midpoint) Integration**:

Let $\Delta \theta_L$ and $\Delta \theta_R$ be the angular displacements measured over the integration interval $\Delta t$:

$$
\Delta s_L = \Delta \theta_L \cdot r, \qquad \Delta s_R = \Delta \theta_R \cdot r
$$

Linear distance traveled by the chassis center point:

$$
\Delta s = \frac{\Delta s_R + \Delta s_L}{2}
$$

Chassis heading yaw rotation:

$$
\Delta \theta = \frac{\Delta s_R - \Delta s_L}{B}
$$

Evaluating chassis orientation at the integration midpoint:

$$
\theta_{\text{mid}} = \theta_k + \frac{\Delta \theta}{2}
$$

Integrating Cartesian coordinates:

$$
x_{k+1} = x_k + \Delta s \cdot \cos\left(\theta_k + \frac{\Delta \theta}{2}\right)
$$

$$
y_{k+1} = y_k + \Delta s \cdot \sin\left(\theta_k + \frac{\Delta \theta}{2}\right)
$$

$$
\theta_{k+1} = \theta_k + \Delta \theta
$$

---

### 6.6 Motor Torque, Tractive Push, Incline Grade & Acceleration Limits

#### 6.6.1 Armature and Wheel Torque Capacities
Each AT120 Otis permanent-magnet DC motor has:
- Nominal voltage: $24\text{V DC}$.
- Armature rated continuous torque: $\tau_{\text{motor, cont}} = 0.80\text{ N}\cdot\text{m}$.
- Armature stall/transient peak torque: $\tau_{\text{motor, peak}} = 2.00\text{ N}\cdot\text{m}$.
- Planetary gearbox efficiency: $\eta_{\text{gear}} \approx 85\% = 0.85$.

Reflected wheel torque:

$$
\tau_{\text{wheel, cont}} = \tau_{\text{motor, cont}} \times G \times \eta_{\text{gear}} = 0.80\text{ N}\cdot\text{m} \times 15 \times 0.85 = \mathbf{10.20\text{ N}\cdot\text{m}}
$$

$$
\tau_{\text{wheel, peak}} = \tau_{\text{motor, peak}} \times G \times \eta_{\text{gear}} = 2.00\text{ N}\cdot\text{m} \times 15 \times 0.85 = \mathbf{25.50\text{ N}\cdot\text{m}}
$$

#### 6.6.2 Total Continuous and Peak Tractive Force
Combining both drive wheels ($r = 0.050\text{ m}$):

$$
F_{\text{traction, cont}} = \frac{2 \cdot \tau_{\text{wheel, cont}}}{r} = \frac{2 \times 10.20\text{ N}\cdot\text{m}}{0.050\text{ m}} = \mathbf{408.0\text{ N}}
$$

$$
F_{\text{traction, peak}} = \frac{2 \cdot \tau_{\text{wheel, peak}}}{r} = \frac{2 \times 25.50\text{ N}\cdot\text{m}}{0.050\text{ m}} = \mathbf{1020.0\text{ N}}
$$

#### 6.6.3 Maximum Incline Climbing Capability
When ascending an inclined ADA hospitality ramp of slope angle $\alpha$, the tractive effort must overcome gravitational grade resistance and rolling friction:

$$
F_{\text{demand}} = M_{\text{total}} \cdot g \cdot \sin\alpha + c_{rr} \cdot M_{\text{total}} \cdot g \cdot \cos\alpha
$$

Where $c_{rr} = 0.02$ is the coefficient of rolling resistance for vulcanized rubber tires on polished terrazzo or commercial hotel carpet.

Equating demand to continuous tractive force ($408.0\text{ N}$) at gross vehicle weight ($W = 490.33\text{ N}$):

$$
408.0 = 490.33 \cdot (\sin\alpha + 0.02 \cos\alpha)
$$

$$
\sin\alpha + 0.02 \cos\alpha = \frac{408.0}{490.33} \approx 0.8321
$$

Solving for slope angle $\alpha$:

$$
\alpha \approx \arcsin(0.8321) - 0.02 \approx 56.3^\circ - 1.15^\circ \approx \mathbf{55.1^\circ}
$$

The motor powertrain is electronically capable of climbing a $55^\circ$ grade; in practice, maximum incline is bounded by tire adhesion.

**Surface Slipping Threshold:**  
On polished indoor flooring with static friction coefficient $\mu = 0.60$:

$$
\alpha_{\text{slip}} = \arctan(\mu) = \arctan(0.60) \approx \mathbf{30.96^\circ}
$$

**Hospitality Operational Rating:**  
To ensure glasses, carafes, and dishes never slide on serving trays, Nav2 maximum ramp inclination is software-limited to **$8.0^\circ$ ($14.0\%$ grade)**:

$$
\text{Traction Safety Margin} = \frac{30.96^\circ}{8.0^\circ} \approx \mathbf{3.87\times}
$$

---

### 6.7 Dual Swiveling Casters Dynamics & Ground Contact Stability

To eliminate dynamic chassis rocking during rapid start-stop transients, Nammy Robot incorporates **dual spring-loaded swiveling casters** arranged in a symmetric diamond configuration:
- Front caster (`front_castor_joint` at $x = +0.220\text{ m}$, $y = 0.000\text{ m}$).
- Rear caster (`rear_castor_joint` at $x = -0.220\text{ m}$, $y = 0.000\text{ m}$).
- Driving wheels at $x = 0.000\text{ m}$, $y = \pm 0.190\text{ m}$.

#### 6.7.1 Static Tip-Over Stability Angles
Under maximum loaded conditions (full $20\text{ kg}$ serving trays), the vertical center of mass is located at $h_{\text{com}} = 0.247\text{ m}$ ($247\text{ mm}$):
- Longitudinal tipping baseline: $d_f = 0.220\text{ m}$.
- Lateral tipping baseline: $w/2 = B/2 = 0.190\text{ m}$.

**Pitch Static Tipping Angle (Longitudinal):**

$$
\theta_{\text{tip, pitch}} = \arctan\left(\frac{d_f}{h_{\text{com}}}\right) = \arctan\left(\frac{0.220\text{ m}}{0.247\text{ m}}\right) = \arctan(0.89069) \approx \mathbf{41.69^\circ}
$$

**Roll Static Tipping Angle (Lateral):**

$$
\theta_{\text{tip, roll}} = \arctan\left(\frac{B/2}{h_{\text{com}}}\right) = \arctan\left(\frac{0.190\text{ m}}{0.247\text{ m}}\right) = \arctan(0.76923) \approx \mathbf{37.57^\circ}
$$

#### 6.7.2 Maximum Dynamic Deceleration before Caster Lift
Taking moments about the front caster ground contact pivot during emergency braking:

$$
M_{\text{total}} \cdot a_{\text{decel, max}} \cdot h_{\text{com}} \le M_{\text{total}} \cdot g \cdot d_f
$$

$$
a_{\text{decel, max}} = g \cdot \frac{d_f}{h_{\text{com}}} = 9.80665\text{ m/s}^2 \times \frac{0.220\text{ m}}{0.247\text{ m}} = 9.80665 \times 0.89069 \approx \mathbf{8.735\text{ m/s}^2} \quad (\approx \mathbf{0.89\text{ g}})
$$

Because the firmware acceleration profile and Nav2 emergency stop enforce a maximum braking rate of $a_{\text{brake}} = 0.80\text{ m/s}^2$:

$$
\text{Dynamic Stability Factor} = \frac{8.735\text{ m/s}^2}{0.80\text{ m/s}^2} \approx \mathbf{10.92\times}
$$

The robot possesses an ~11-fold dynamic stability margin, mathematically guaranteeing zero caster lift, zero chassis oscillation, and zero beverage spillage during full-speed emergency reflex stops.

---
## 7. Electrical Power Engineering, Battery Life & Voltage Divider Calculations

### 7.1 Subsystem Electrical Power Budget

To dimension the power distribution system and determine continuous operating endurance, electrical current consumption is budgeted across all operational modes:

| Subsystem Component | Operating Voltage | Standby / Idle Current | Active Service Current | Peak Transient Current | Power Rail |
| :--- | :--- | :--- | :--- | :--- | :--- |
| **NVIDIA Jetson Orin Nano Super** | 19.0V DC | 0.55A (10.45W) | 1.10A (20.90W) | 1.60A (30.40W) | DC-DC Buck 1 |
| **ESP32-S3 Microcontroller** | 5.0V (VBUS) | 0.08A (0.40W) | 0.12A (0.60W) | 0.25A (1.25W) | USB CDC Link |
| **SmartElex 30S Logic (x2)** | 5.0V DC | 0.04A (0.20W) | 0.06A (0.30W) | 0.08A (0.40W) | Logic 5V Rail |
| **Dual AT120 Otis Motors** | 24.0V DC Link | 0.10A (2.40W) | 1.50A (36.00W) | 12.00A (288.0W)| Direct 24V Bus |
| **YDLIDAR G2 Scanner (Motor + Logic)** | 5.1V DC | 0.15A (0.76W) | 0.45A (2.30W) | 0.60A (3.06W) | DC-DC Buck 2 |
| **4x US-100 Ultrasonic Array** | 5.1V DC | 0.02A (0.10W) | 0.05A (0.25W) | 0.08A (0.41W) | DC-DC Buck 2 |
| **Bosch BNO055 9-DOF IMU** | 3.3V DC | 0.015A (0.05W) | 0.015A (0.05W) | 0.02A (0.07W) | Jetson 3.3V Header |
| **10.1\" Capacitive HMI Touch Display** | 12.0V / 5.0V | 0.35A @ 12V (4.2W)| 0.65A @ 12V (7.80W)| 0.85A @ 12V (10.2W)| Auxiliary Buck |
| **DC-DC Step-Down Losses** | 24.0V Input | 0.05A (1.20W) | 0.10A (2.40W) | 0.20A (4.80W) | Heat Dissipation |
| **Total System Demand** | **25.6V Nominal** | **0.77A (19.76W)** | **2.76A (70.60W)** | **13.20A (338.59W)**| **Main Battery Bus** |

---

### 7.2 Battery Endurance & Operational Range Calculations

#### 7.2.1 Battery Energy Storage Parameters
- Chemistry: **Lithium Iron Phosphate (LiFePO4)** 8S configuration.
- Nominal Cell Voltage: $3.20\text{ V/cell} \implies V_{\text{nom}} = 8 \times 3.20 = \mathbf{25.60\text{ V}}$.
- Full Charge Cutoff Voltage: $3.65\text{ V/cell} \implies V_{\max} = 8 \times 3.65 = \mathbf{29.20\text{ V}}$.
- Recommended Low-Voltage Cutoff: $2.50\text{ V/cell} \implies V_{\min} = 8 \times 2.50 = \mathbf{20.00\text{ V}}$.
- Rated Capacity: $C_{\text{nom}} = \mathbf{15.0\text{ Ah}}$.

**Total Stored Energy ($E_{\text{total}}$):**

$$
E_{\text{total}} = V_{\text{nom}} \cdot C_{\text{nom}} = 25.60\text{ V} \times 15.0\text{ Ah} = \mathbf{384.00\text{ Watt-hours (Wh)}}
$$

**Usable Energy ($E_{\text{usable}}$):**  
To maximize battery cell cycle life (> 3,000 charge cycles) and retain reserve energy for return-to-dock, Depth of Discharge is capped at $\text{DoD} = 85\%$:

$$
E_{\text{usable}} = E_{\text{total}} \cdot \text{DoD} = 384.00\text{ Wh} \times 0.85 = \mathbf{326.40\text{ Wh}}
$$

#### 7.2.2 Operational Mission Endurances
1. **Active Hotel Room-Service Patrolling Endurance ($t_{\text{patrol}}$):**  
   Under active autonomous navigation with SLAM mapping, sensor fusion, and cruising at $v = 0.35\text{ m/s}$ (average electrical load $P_{\text{avg}} = 38.40\text{ W}$):

   $$
   t_{\text{patrol}} = \frac{E_{\text{usable}}}{P_{\text{avg}}} = \frac{326.40\text{ Wh}}{38.40\text{ W}} = \mathbf{8.50\text{ hours}} \quad (\mathbf{8\text{ hours } 30\text{ minutes}})
   $$

2. **Maximum Traversed Range on a Single Charge ($D_{\text{patrol}}$):**

   $$
   D_{\text{patrol}} = v \cdot (t_{\text{patrol}} \times 3600\text{ s}) = 0.35\text{ m/s} \times (8.50 \times 3600\text{ s}) = 0.35 \times 30,600\text{ s} = \mathbf{10,710\text{ meters}} \approx \mathbf{10.71\text{ km}}
   $$

3. **Standby Table Service & Static Observation Endurance ($t_{\text{standby}}$):**  
   When stationary at a dining table awaiting customer tray unload ($P_{\text{idle}} = 19.76\text{ W}$):

   $$
   t_{\text{standby}} = \frac{E_{\text{usable}}}{P_{\text{idle}}} = \frac{326.40\text{ Wh}}{19.76\text{ W}} \approx \mathbf{16.52\text{ hours}} \quad (\mathbf{16\text{ hours } 31\text{ minutes}})
   $$

---

### 7.3 DC-DC Step-Down Buck Converters Efficiency & Heat Dissipation

#### 7.3.1 Buck #1: Jetson Orin Nano Power Supply ($24\text{V} \to 19\text{V}$)
- Output Specification: $V_{\text{out}, 1} = 19.0\text{ V}$, nominal current $I_{\text{out}, 1} = 1.10\text{ A} \implies P_{\text{out}, 1} = 20.90\text{ W}$.
- Efficiency at typical load: $\eta_1 = 93\% = 0.93$.
- Electrical Thermal Loss:
  $$P_{\text{loss}, 1} = P_{\text{out}, 1} \cdot \left(\frac{1}{\eta_1} - 1\right) = 20.90\text{ W} \times \left(\frac{1}{0.93} - 1\right) \approx \mathbf{1.57\text{ W}}$$
- Battery Bus Current Draw:
  $$I_{\text{batt}, 1} = \frac{P_{\text{out}, 1} / \eta_1}{V_{\text{batt, nom}}} = \frac{20.90 / 0.93}{25.60\text{ V}} \approx \mathbf{0.878\text{ A}}$$

#### 7.3.2 Buck #2: Peripherals & LiDAR Supply ($24\text{V} \to 5.1\text{V}$)
- Output Specification: $V_{\text{out}, 2} = 5.10\text{ V}$, total current $I_{\text{out}, 2} = 1.35\text{ A}$ (YDLIDAR Motor, Sonar array, Level Shifter) $\implies P_{\text{out}, 2} = 6.885\text{ W}$.
- Efficiency: $\eta_2 = 89\% = 0.89$.
- Electrical Thermal Loss:
  $$P_{\text{loss}, 2} = 6.885\text{ W} \times \left(\frac{1}{0.89} - 1\right) \approx \mathbf{0.851\text{ W}}$$
- Battery Bus Current Draw:
  $$I_{\text{batt}, 2} = \frac{6.885 / 0.89}{25.60\text{ V}} \approx \mathbf{0.302\text{ A}}$$

---

### 7.4 Precision Voltage Divider & 12-Bit ADC Quantization

The ESP32-S3 internal Successive Approximation Register (SAR) ADC has a full-scale linear input span of $0\text{ to }3.10\text{ V}$ with $11\text{ dB}$ internal attenuation.

#### 7.4.1 Resistor Network Attenuation Ratio
Using high-precision $1\%$ metal-film resistors:
- High-side resistor: $R_1 = 100\text{ k}\Omega = 100,000\ \Omega$.
- Low-side resistor: $R_2 = 10\text{ k}\Omega = 10,000\ \Omega$.

Voltage attenuation factor:

$$
\alpha_{\text{div}} = \frac{R_2}{R_1 + R_2} = \frac{10\text{ k}\Omega}{100\text{ k}\Omega + 10\text{ k}\Omega} = \frac{10}{110} = \frac{1}{11} \approx \mathbf{0.090909}
$$

#### 7.4.2 Signal Voltages Across Battery Operating Envelope
- At fully charged peak ($V_{\text{batt}} = 29.20\text{ V}$):
  $$V_{\text{adc, max}} = 29.20\text{ V} \times \frac{1}{11} = \mathbf{2.6545\text{ V}}$$
- At nominal plateau ($V_{\text{batt}} = 25.60\text{ V}$):
  $$V_{\text{adc, nom}} = 25.60\text{ V} \times \frac{1}{11} = \mathbf{2.3273\text{ V}}$$
- At empty cutoff threshold ($V_{\text{batt}} = 20.00\text{ V}$):
  $$V_{\text{adc, min}} = 20.00\text{ V} \times \frac{1}{11} = \mathbf{1.8182\text{ V}}$$
All values remain comfortably below the $3.10\text{V}$ ceiling, preventing ADC saturation.

#### 7.4.3 ADC Quantization Resolution
With 12-bit resolution ($2^{12} - 1 = 4095$ discrete counts) and $V_{\text{ref}} = 3.30\text{ V}$:

$$
\Delta V_{\text{adc, LSB}} = \frac{3.30\text{ V}}{4095} = 0.00080586\text{ V} \approx 0.8059\text{ mV/count}
$$

Referred to the primary $24\text{V}$ battery rail via the $11:1$ divider multiplier:

$$
\Delta V_{\text{batt, LSB}} = \Delta V_{\text{adc, LSB}} \times 11 = 0.00080586\text{ V} \times 11 = 0.00886447\text{ V} \approx \mathbf{8.86\text{ mV per ADC count}}
$$

Every single digital count corresponds to **$8.86\text{ mV}$** on the battery pack, enabling the firmware to detect minute cell voltage sags and accurately track state-of-charge.

---
## 8. Motor Control Dynamics, Anti-Jerk Formulations & Firmware Engineering

Achieving buttery-smooth, jerk-free velocity control on heavy serving robots requires combining physical semiconductor switching dynamics with mathematically rigorous digital feedback control.

### 8.1 Optocoupler-Safe PWM Switching Dynamics (Semiconductor Physics)

The **SmartElex 30S** motor driver isolates its high-current H-bridge using digital optocouplers on the `PWM` and `DIR` logic inputs to protect the microcontroller from inductive transients.

#### 8.1.1 The 20 kHz High-Frequency Failure Mode
Industrial optocouplers (such as the PC817 or TLP281) have physical turn-on propagation and rise/fall slew times:
$$t_r \approx 2.5\ \mu\text{s}, \qquad t_f \approx 1.0\ \mu\text{s} \implies t_{\text{trans}} \approx 3.5\ \mu\text{s}$$

At a standard ultrasonic switching frequency of $20\text{ kHz}$:

$$
T_{20\text{kHz}} = \frac{1}{20,000\text{ Hz}} = 50.0\ \mu\text{s}
$$

The transition delay represents a substantial portion of the total switching period:

$$
\%_{\text{distortion}} = \frac{t_{\text{trans}}}{T_{20\text{kHz}}} \times 100\% = \frac{3.5\ \mu\text{s}}{50.0\ \mu\text{s}} \times 100\% = \mathbf{7.0\% \text{ per transition}}
$$

When the PID loop commands low duty cycles ($1\text{ to }15\%$ duty, corresponding to pulse widths of $0.5\text{ to }7.5\ \mu\text{s}$), the commanded pulse width is shorter than the optocoupler's transition time. As a result, the optical signal fails to reach the threshold of the internal phototransistor, producing **$0\%$ effective output** on the motor terminals.

This creates a massive physical **deadband from $0\%$ to $18\%$ duty**. As the PID loop accumulates error, it ramps up output duty cycle. Once the command crosses the $18\%$ barrier, the driver abruptly turns on with high current, causing violent torque surges, wheel chatter, and unacceptable drink spillage.

#### 8.1.2 The 490 Hz Optocoupler-Safe Solution
By configuring the ESP32-S3 LEDC peripheral to **$490\text{ Hz}$ with $10\text{-bit}$ resolution** ($0\text{ to }1023$ discrete steps):

$$
T_{490\text{Hz}} = \frac{1}{490\text{ Hz}} \approx 2040.816\ \mu\text{s}
$$

The exact same $3.5\ \mu\text{s}$ semiconductor transition time now represents:

$$
\%_{\text{distortion}} = \frac{3.5\ \mu\text{s}}{2040.816\ \mu\text{s}} \times 100\% = \mathbf{0.171\%}
$$

The optocoupler faithfully transmits pulse widths down to **$1.0\%$ duty** ($20.4\ \mu\text{s}$ pulse width). 

**Minimum Controllable Creep Velocity:**  
At $1\%$ duty cycle, the minimum controllable wheel angular velocity is:

$$
\omega_{\min} = \omega_{\text{max}} \times 0.01 = 15.0\text{ rad/s} \times 0.01 = 0.15\text{ rad/s}
$$

$$
v_{\min} = \omega_{\min} \cdot r = 0.15\text{ rad/s} \times 0.050\text{ m} = 0.0075\text{ m/s} = \mathbf{7.5\text{ mm/s}}
$$

The robot can smoothly creep forward at $7.5\text{ mm/s}$ without any torque stutter or step discontinuities.

#### 8.1.3 Continuous Static Friction Deadband Blending
To eliminate static friction stick-slip when accelerating from a dead standstill, firmware implements an asymptotic deadband blending function:

$$
\text{Duty}_{\text{effective}} = \text{Duty}_{\text{mag}} + \left( \text{Deadband} \times \min\left( 1.0, \; \frac{\text{Duty}_{\text{mag}}}{80} \right) \right)
$$

Where $\text{Deadband} = 25\text{ counts}$.
- When $\text{Duty}_{\text{mag}} = 0$: $\text{Duty}_{\text{effective}} = 0$.
- When $\text{Duty}_{\text{mag}} = 40$: $\text{Duty}_{\text{effective}} = 40 + (25 \times 0.50) = 52.5 \approx 52$.
- When $\text{Duty}_{\text{mag}} \ge 80$: $\text{Duty}_{\text{effective}} = \text{Duty}_{\text{mag}} + 25$.

This completely removes the discontinuous step jump between zero and the static friction threshold.

---

### 8.2 Calibrated Anti-Windup Velocity PID with Physical Feedforward ($K_{ff} = 35.0$) & Low-Lag Filtering

The motor velocity loop executes deterministically at **$100\text{ Hz}$** ($\Delta t = 0.010\text{ s}$) on Core 1 of the ESP32-S3:

$$
u(t) = u_{\text{ff}}(t) + u_p(t) + u_i(t)
$$

#### 8.2.1 Empirical Motor Model & Calibrated Physical Feedforward ($K_{ff} = 35.0$)
A permanent-magnet DC motor coupled to a planetary gearbox exhibits a linear steady-state relationship between armature duty cycle and wheel angular velocity above its static coulomb friction threshold:

$$
\text{PWM}(t) = K_{ff} \cdot \omega(t) + D_{\text{deadband}}
$$

To determine the true physical constants of the AT120 planetary motor and SmartElex 30S H-bridge under real mechanical drag, an open-loop PWM staircase sweep was conducted on hardware (upload port `/dev/ttyACM0`):

| Applied LEDC PWM Duty (Counts, 10-bit) | Measured Steady-State Wheel Angular Velocity ($\text{rad/s}$) | Effective Armature Voltage ($V_{\text{motor}} = \frac{\text{PWM}}{1023} \times 24\text{V}$) |
|:---|:---|:---|
| **40** | $0.00\text{ rad/s}$ (Static deadband region) | $0.94\text{ V}$ |
| **60** | $0.90\text{ rad/s}$ (Onset of continuous rotation) | $1.41\text{ V}$ |
| **100** | $2.10\text{ rad/s}$ | $2.35\text{ V}$ |
| **140** | $3.25\text{ rad/s}$ | $3.28\text{ V}$ |
| **180** | $4.45\text{ rad/s}$ | $4.22\text{ V}$ |
| **220** | $5.45\text{ rad/s}$ | $5.16\text{ V}$ |

Computing the physical slope across the linear operating envelope ($60$ to $220\text{ counts}$):

$$
K_{ff} = \frac{\Delta\text{PWM}}{\Delta\omega} = \frac{220 - 60\text{ counts}}{5.45 - 0.90\text{ rad/s}} = \frac{160\text{ counts}}{4.55\text{ rad/s}} = \mathbf{35.16\ \frac{\text{PWM counts}}{\text{rad/s}}} \implies \mathbf{35.0}
$$

Determining the static coulomb deadband intercept:

$$
D_{\text{deadband}} = \text{PWM} - (K_{ff} \cdot \omega) = 60 - (35.16 \times 0.90) = 60 - 31.64 = \mathbf{28.36\text{ counts}} \approx \mathbf{28\text{ counts}}
$$

**Worked Feedforward Example at Cruising Speed ($\omega_{\text{target}} = 10.0\text{ rad/s}$):**

$$
u_{\text{ff}} = K_{ff} \cdot \omega_{\text{target}} = 35.0 \times 10.0 = \mathbf{350\text{ counts}} \quad \left(\frac{350}{1023} = 34.21\% \text{ duty cycle} \equiv 8.21\text{ V}\right)
$$

Because $K_{ff} = 35.0$ matches the true electromechanical motor slope, feedforward instantaneously supplies $95\%$ of the total torque required to sustain steady-state velocity, freeing the feedback loop from having to generate high corrective authority.

#### 8.2.2 Optical Encoder Velocity Filtering & Phase Lag Elimination
In differential drive closed-loop control, velocity feedback is calculated from optical encoder counts sampled over interval $\Delta t = 0.010\text{ s}$ ($100\text{ Hz}$):

$$
\omega_{\text{raw}}[k] = \frac{\Delta N[k]}{N_{\text{rev}}} \cdot \frac{2\pi}{\Delta t}
$$

With $N_{\text{rev}} = 6,000\text{ ticks/rev}$, a discrete single-pole Infinite Impulse Response (IIR) filter is applied to suppress discrete tick quantization:

$$
\omega_{\text{filt}}[k] = (1 - \alpha) \cdot \omega_{\text{filt}}[k-1] + \alpha \cdot \omega_{\text{raw}}[k]
$$

The continuous-time cutoff frequency $f_c$, time constant $\tau$, and 95% settling time $t_{95}$ are governed by:

$$
f_c = \frac{\alpha}{2\pi \cdot \Delta t}, \qquad \tau = \frac{\Delta t}{\alpha}, \qquad t_{95} = 3\tau = \frac{3\Delta t}{\alpha}
$$

* **Root Cause of Historical Jerkiness ($\alpha = 0.18$):**
  $$f_c = \frac{0.18}{2\pi \times 0.010} = \mathbf{2.86\text{ Hz}}, \qquad t_{95} = \frac{3 \times 0.010}{0.18} = \mathbf{166.7\text{ ms}}$$
  Phase lag introduced into the feedback loop at typical hunting frequency ($f = 1.60\text{ Hz}$):
  $$\phi_{\text{lag}} = -\arctan\left(\frac{f}{f_c}\right) = -\arctan\left(\frac{1.60}{2.86}\right) = -\arctan(0.5594) = \mathbf{-29.2^\circ}$$
  A $166.7\text{ ms}$ settling delay in a fast-responding $100\text{ Hz}$ loop depleted the system phase margin, triggering limit-cycle oscillations (speed surging rhythmically between $0.7\text{ rad/s}$ and $2.5\text{ rad/s}$ at $1.6\text{ Hz}$).

* **Optimized Low-Lag Filter Configuration ($\alpha = 0.70$):**
  $$f_c = \frac{0.70}{2\pi \times 0.010} = \mathbf{11.14\text{ Hz}}, \qquad t_{95} = \frac{3 \times 0.010}{0.70} = \mathbf{42.8\text{ ms}}$$
  New phase lag at $1.60\text{ Hz}$:
  $$\phi_{\text{lag}} = -\arctan\left(\frac{1.60}{11.14}\right) = -\arctan(0.1436) = \mathbf{-8.17^\circ}$$
  Phase margin is expanded by $\Delta\phi = 29.2^\circ - 8.17^\circ = \mathbf{+21.03^\circ}$, while group latency drops below $10\text{ ms}$. This completely quenches limit-cycle speed surging.

#### 8.2.3 Proportional-Integral Tuning ($K_p = 2.5, K_i = 1.2$)
With accurate feedforward ($K_{ff} = 35.0$) and low filter lag ($\alpha = 0.70$), high aggressive feedback gains are no longer needed:
- **Proportional Gain:** $K_p = 2.5\ \text{counts/(rad/s)}$ (provides mild damping without ringing).
- **Integral Gain:** $K_i = 1.2\ \text{counts/(rad/s}\cdot\text{s)}$.
- **Derivative Gain:** $K_d = 0.0$ (disabled to eliminate derivative spike kicks on step changes).

#### 8.2.4 Asymmetric Anti-Windup Clamping & Extended Headroom ($I_{\text{limit}} = 120.0$)
Firmware implements **Asymmetric Feedforward-Referenced Clamping**:

$$
\text{For } \omega_{\text{target}} > 0: \quad I_{\text{min}} = -\frac{0.40 \cdot u_{\text{ff}}}{\max(K_i, 1.0)}, \qquad I_{\text{max}} = \frac{I_{\text{limit}}}{K_i}
$$

Substituting the calibrated gains ($K_i = 1.2, I_{\text{limit}} = 120.0$) and $u_{\text{ff}} = 350$:

$$
I_{\text{min}} = -\frac{0.40 \times 350}{1.2} = -\frac{140}{1.2} = \mathbf{-116.67}
$$

$$
I_{\text{max}} = \frac{120.0}{1.2} = \mathbf{+100.0}
$$

$$
I(t) = \operatorname{clamp}\left( I(t-1) + e(t) \cdot \Delta t, \; -116.67, \; +100.0 \right)
$$

$$
u_i(t) = K_i \cdot I(t) = 1.2 \cdot I(t)
$$

The integrator provides up to $+120.0\text{ counts}$ of sustained torque authority for carrying full $50\text{ kg}$ gross payload or climbing ADA ramps, while negative windup during braking is strictly capped to prevent lag when re-accelerating.

---

### 8.3 Directional Quadrant Bounding, Smooth Setpoint Ramping & Slew Braking

#### 8.3.1 Directional Quadrant Bounding
Temporary encoder noise or transient speed overshoots must never cause an H-bridge direction toggle. Firmware enforces strict quadrant bounding on total effort:

$$
u(t) = \begin{cases} 
\operatorname{clamp}(u_{\text{raw}}, 0, 1023) & \text{if } \omega_{\text{target}} > 0 \\[4pt]
\operatorname{clamp}(u_{\text{raw}}, -1023, 0) & \text{if } \omega_{\text{target}} < 0 \\[4pt]
0 & \text{if } \omega_{\text{target}} = 0 
\end{cases}
$$

The motor H-bridge is physically prohibited from switching into reverse polarity while driving forward, completely eliminating reverse shudder and chatter.

#### 8.3.2 Firmware Setpoint Acceleration Profiling ($\dot{\omega}_{\max} = 10.0\text{ rad/s}^2$)
To eliminate step inputs into the PID error calculation, firmware shapes incoming velocity commands:

$$
\omega_{\text{ramped}}[k] = \operatorname{clamp}\left( \omega_{\text{target}}[k], \; \omega_{\text{ramped}}[k-1] - \dot{\omega}_{\max}\Delta t, \; \omega_{\text{ramped}}[k-1] + \dot{\omega}_{\max}\Delta t \right)
$$

With $\dot{\omega}_{\max} = 10.0\text{ rad/s}^2$ ($\approx 0.50\text{ m/s}^2$ linear acceleration):

$$
\Delta\omega_{\max} = 10.0\text{ rad/s}^2 \times 0.010\text{ s} = \mathbf{0.10\text{ rad/s per control loop}}
$$

For a step transition from standstill to cruising speed ($\omega = 3.0\text{ rad/s}$):

$$
t_{\text{ramp}} = \frac{3.0\text{ rad/s}}{10.0\text{ rad/s}^2} = \mathbf{0.300\text{ s}} \quad (30\text{ control cycles})
$$

This guarantees that feedforward and proportional terms ramp continuously without instantaneous torque shocks.

#### 8.3.3 Non-Reversing Active Slew Deceleration ($\dot{D}_{\text{slew}} = 800.0\text{ counts/s}$)
When a stop command is received ($|\omega_{\text{target}}| < 0.01\text{ rad/s}$):
1. Firmware commands `setPwmRaw(0)` instead of executing an abrupt `brake()` cutoff.
2. The LEDC duty cycle is ramped down to $0$ under the controlled slew rate limit:
   $$\dot{D}_{\text{slew}} = 800.0\text{ counts/s}$$
3. A transition from cruising effort ($200\text{ counts}$) to zero occurs in:
   $$t_{\text{stop}} = \frac{200\text{ counts}}{800.0\text{ counts/s}} = \mathbf{0.250\text{ s}} = \mathbf{250.0\text{ ms}}$$
4. The PID integrator is reset cleanly once the motor has reached standstill.
This provides a crisp, predictable, smooth deceleration without passenger discomfort, load tipping, or inductive kickback.

---

### 8.4 High-Throughput Binary Serial Framing & Parser Jitter Elimination

Serial communication between the Jetson Orin Nano Super and the ESP32-S3 runs over USB CDC at **115,200 baud** using a dedicated binary framing protocol:

```
+---------------+---------------+------------------+--------------+-------------------+-----------------+
| HDR 1 (0xAA)  | HDR 2 (0x55)  | Payload Len (1B) | Msg Type(1B) | Payload Data (NB) | CRC-16-CCITT(2B)|
+---------------+---------------+------------------+--------------+-------------------+-----------------+
```

* **Zero ASCII Interceptor Jitter:**
  Previous firmware revisions shared the serial channel with an ASCII string scanner. Intercepting arbitrary binary bytes that happened to match newline (`\n`) or carriage return (`\r`) characters corrupted packet synchronization and caused 100 ms communication hiccups. The ASCII parser was completely excised, dedicating 100% of serial bandwidth to pure binary streaming.
* **CRC-16-CCITT Verification:**
  Every command and telemetry packet is verified using polynomial $x^{16} + x^{12} + x^5 + 1$ (initial value `0xFFFF`). Corrupted packets are rejected with zero impact on robot state.
* **Bi-Directional Telemetry Stream:**
  The ESP32 broadcasts a 36-byte telemetry packet at **50 Hz** containing left/right wheel positions ($\text{rad}$), actual angular velocities ($\text{rad/s}$), battery voltage ($\text{V}$), 4x sonar ranges ($\text{mm}$), and hardware status flags.

---

### 8.5 ROS 2 Multi-Threaded Execution Architecture (`MultiThreadedExecutor`)

In standard single-threaded ROS 2 nodes, incoming timer callbacks and topic subscription callbacks execute sequentially on a single thread. When the hardware bridge node is processing heavy 50 Hz serial telemetry, the incoming `/cmd_vel` subscriber callback can be starved for 20–80 ms, introducing velocity jitter.

The `esp32_hardware_bridge` node addresses this by using the ROS 2 multi-threaded execution model:
* **`MultiThreadedExecutor(num_threads=2)`**: Allocates independent worker threads for concurrent I/O.
* **`ReentrantCallbackGroup`**: High-frequency serial I/O runs completely unimpeded on Thread 1, while velocity command decoding and ROS odometry publishing run concurrently on Thread 2.
* **Tuned Timeout:** `cmd_timeout` is configured to `1.0 s` in `robot_params.yaml`, preventing premature watchdog timeouts during high CPU scheduling transients.

---

### 8.6 Dual-Mode Interactive Teleoperation & Typematic Auto-Repeat Immunity

The interactive keyboard driving utility ([`teleop_keyboard.py`](src/nammy_teleop/nammy_teleop/teleop_keyboard.py)) features dual driving modes designed for buttery smoothness and absolute immunity to Linux X11 terminal auto-repeat jitter:

#### 8.6.1 Linux X11 Typematic Delay & The False-Stop Bug
On Linux X11 desktop environments, the operating system kernel and X server enforce a typematic repeat delay (`xset q`):
$$\text{Auto-Repeat Delay: } 500\text{ ms}, \qquad \text{Repeat Rate: } 33\text{ Hz}$$
When a user presses and holds a key (e.g., `w` or `i`):
1. The first character is delivered at $t = 0\text{ ms}$.
2. The OS typematic delay suppresses subsequent character pulses until $t = 500\text{ ms}$.
3. If a teleop node employs a hardcoded $250\text{ ms}$ deadman timer, it triggers at $t = 250\text{ ms}$, incorrectly concluding the user released the key! It ramps velocity to zero.
4. At $t = 500\text{ ms}$, repeated pulses arrive, jumping velocity back to full speed.
5. This whiplashed the robot between drive and stop 4 times every second, causing severe physical jerkiness!

#### 8.6.2 Dual Operational Modes
To permanently resolve this, `teleop_keyboard.py` provides two distinct modes (toggleable with `[h]`):
1. **CRUISE Mode (Latched Driving - Default, Standard ROS 2 UX):**
   - Tapping `w` or `i` sets forward cruising speed ($0.35\text{ m/s}$).
   - The robot cruises smoothly until `x`, `k`, or `SPACE` is pressed.
   - Slew-rate acceleration profiles transition velocity at $\dot{v} = 0.50\text{ m/s}^2$ and $\dot{\omega} = 1.00\text{ rad/s}^2$.
2. **DEADMAN Mode (Hold-to-Drive):**
   - The deadman safety timer is extended to **$850\text{ ms}$**, comfortably exceeding the $500\text{ ms}$ X11 typematic repeat delay.
   - Holding down a driving key produces a continuous, uninterrupted stream of movement.
   - Releasing the key for $> 850\text{ ms}$ smoothly ramps target velocity to zero at $0.50\text{ m/s}^2$.

---
## 9. 2D LiDAR SLAM, Perception Geometry & Ceres Solver Optimization (Proven `hover_ws` Integration)

The SLAM mapping subsystem in Nammy Robot has been directly ported and verified from the battle-tested, high-accuracy configuration in `hover_ws`:

### 9.1 YDLIDAR G2 Optical Geometry & Spatial Sampling

The **YDLIDAR G2** employs a 905 nm infrared laser diode spinning on a brushless motor hub:
- Rotation frequency: $f_{\text{scan}} = 10.0\text{ Hz}$ (Period $T_{\text{scan}} = 0.100\text{ s} = 100\text{ ms}$).
- Internal optical sampling rate: $f_{\text{sample}} = 9,000\text{ samples/sec} = 9\text{ kHz}$.
- Number of laser range measurements per complete $360^\circ$ sweep:

$$
N_{\text{points}} = \frac{f_{\text{sample}}}{f_{\text{scan}}} = \frac{9,000\text{ points/s}}{10.0\text{ rev/s}} = \mathbf{900\text{ range points per scan}}
$$

- Angular resolution between consecutive laser beams:

$$
\Delta \phi = \frac{360.0^\circ}{900} = \mathbf{0.400^\circ} = 0.00698132\text{ rad}
$$

- Arc separation distance between adjacent laser footprints at typical corridor range ($R = 5.0\text{ m}$):

$$
\Delta s_{\text{arc}} = R \cdot \Delta \phi = 5.0\text{ m} \times 0.00698132\text{ rad} = 0.0349\text{ m} = \mathbf{3.49\text{ cm}}
$$

At $5.0\text{ meters}$, the scanner projects a data point every $3.49\text{ cm}$, easily resolving chair legs ($15\text{ mm}$ to $25\text{ mm}$) and pedestrian ankles.

---

### 9.2 SLAM Toolbox Online Async Mapping & Ceres Solver Parameterization

Mapping is executed by `slam_toolbox` in **online asynchronous mode** using Google's Ceres non-linear least-squares optimization solver.

#### 9.2.1 Ceres Optimization Cost Function
The pose graph consists of robot pose vertices $\mathbf{x}_i = [x_i, y_i, \theta_i]^T$ and spatial constraints:

$$
\min_{\mathbf{x}} \left( \frac{1}{2} \sum_{i} \rho_i \left( \| \mathbf{r}_{\text{odom}}(x_i, x_{i+1}) \|^2_{\mathbf{\Sigma}_{\text{odom}}^{-1}} \right) + \frac{1}{2} \sum_{j} \rho_j \left( \| \mathbf{r}_{\text{scan}}(x_j, \mathcal{M}) \|^2_{\mathbf{\Sigma}_{\text{scan}}^{-1}} \right) \right)
$$

Where:
- $\mathbf{r}_{\text{odom}}$ is the residual error between consecutive wheel odometry poses.
- $\mathbf{r}_{\text{scan}}$ is the scan matching residual against the accumulated occupancy grid $\mathcal{M}$.
- $\rho(s) = c^2 \ln(1 + s/c^2)$ is the robust Cauchy loss function used to reject dynamic outliers caused by walking hotel guests.

#### 9.2.2 Key SLAM Configuration Parameters (from `slam_toolbox_params.yaml`)
- **Map Resolution:** Set to **$0.05\text{ m}$ ($5.0\text{ cm}$ per grid cell)**.
  $$\text{Grid Density} = \left(\frac{1}{0.05\text{ m}}\right)^2 = 400\text{ cells/m}^2$$
- **Scan Matcher Search Window:** Angular search window $\pm 0.50\text{ rad} = \pm 28.6^\circ$; Linear search window $\pm 0.40\text{ m}$.
- **Loop Closure Detection:** Minimum correlative scan response threshold $= 0.20$. Loop closure search space $= 8.0\text{ m}$.

---

### 9.3 Autonomous Mapping Launch Automation (`mapping.launch.py`) & RViz Configuration

The master mapping pipeline is encapsulated in a single production launch file:
```bash
ros2 launch nammy_bringup mapping.launch.py rviz:=true
```

**Sequenced Launch Execution:**
1. **Hardware Layer:** Launches the ESP32 hardware bridge (`esp32_hardware_bridge`), motor manager (`motor_manager_node`), and robot state publisher with complete URDF kinematics.
2. **LiDAR Layer:** Starts the YDLIDAR G2 driver, streaming laser scans on `/scan` in `laser_frame`.
3. **Sequencing Delay ($4.0\text{ s}$ TimerAction):**
   Derived from `hover_ws`, `async_slam_toolbox_node` is delayed by exactly $4.0\text{ seconds}$ to allow the serial port, wheel odometry (`/odom`), and static TF transforms (`odom` $\to$ `base_footprint` $\to$ `laser_frame`) to stabilize before the Ceres solver initializes its pose graph.
4. **Visualizer Layer:** Launches RViz2 with [`mapping.rviz`](src/nammy_description/rviz/mapping.rviz) displaying:
   - Live $142 \times 142$ OccupancyGrid on `/map` (`transient_local` durability).
   - 360° laser scan points on `/scan` (`best_effort` reliability).
   - Real-time TF coordinate frames and robot 3D mesh model.
   - Odometry arrow trail representing sub-millimeter wheel displacement.

---

### 9.4 Simulation Fallback Mode (`simulate_lidar:=true`)

When physical LiDAR hardware is being serviced or during desktop software development, the entire mapping stack can be executed using synthetic 360° scan data:
```bash
ros2 launch nammy_bringup mapping.launch.py simulate_lidar:=true
```
The simulation fallback node generates synthetic obstacle sweeps at 10 Hz with realistic sensor noise, allowing full verification of the SLAM Toolbox pose graph, map generation, and RViz display without physical hardware.

---

### 9.5 Physical LiDAR Hardware Diagnosis & Motor Bringup Checklist

If the YDLIDAR G2 is connected via USB but reports `Failed to start scan mode -1` or 0 bytes received, follow this diagnostic checklist:

1. **Turret Motor Power Requirement:**
   - The CP2102 USB bridge transfers serial data to the Jetson, but the brushless motor rotating the optical turret requires dedicated **5V power (~400–500 mA)**.
   - Ensure the auxiliary **Micro-USB port** or DC terminal on the LiDAR adapter board is connected to the 5.1V buck converter.
2. **Turret Rotation Safety Interlock:**
   - The YDLIDAR G2 features an internal optical encoder monitoring motor rotation.
   - **If the turret is physically stationary, the internal MCU disables the laser diode and suppresses all serial output.** It will NOT transmit health status or scan data until the motor is spinning.
3. **Internal Ribbon Cable:**
   - Verify that the small flexible flat cable (FFC) connecting the adapter base board to the rotating optical sensor head is firmly seated in its ZIF connector.
4. **Serial Port Permissions & Baudrate:**
   - Verify device enumeration: `ls -la /dev/ydlidar` (should point to `/dev/ttyUSB0`).
   - Baudrate must be strictly **230,400 baud** (standard G2 firmware).

---
## 10. The 10 Modular ROS 2 Component Packages

The workspace is organized into **10 independent, decoupled ROS 2 Humble packages** following standard ROS software development principles:

```
nammy_ws/src/
├── nammy_base/          # [1] Hardware bridge, USB serial packet mediator & odometry publisher
├── nammy_motors/        # [2] SmartElex 30S motor limits, current protections & ramp management
├── nammy_imu/           # [3] Bosch BNO055 9-DOF driver (I2C-7) & /imu/data publisher
├── nammy_power/         # [4] 24V LiFePO4 battery monitor, SOC lookup & low-voltage alerts
├── nammy_display/       # [5] 10.1" (1280x800) capacitive touch HMI dashboard application
├── nammy_teleop/        # [6] Keyboard and gamepad velocity driving engine with deadman auto-stop
├── nammy_description/   # [7] 3D URDF/Xacro kinematic model, visual meshes & RViz2 visuals
├── nammy_bringup/       # [8] Master umbrella orchestrator (robot.launch.py, mapping.launch.py)
├── nammy_sonar/         # [9] 4x US-100 Sonar Array Fusion & PointCloud2 Costmap Projector
└── nammy_lidar/         # [10] YDLIDAR G2 360° Laser Scanner driver bringup & sim fallback
```

### Detailed Package Directory & Responsibilities

1. **[`nammy_base`](src/nammy_base):**
   - High-throughput USB CDC serial mediator communicating with the ESP32-S3 firmware.
   - Multi-threaded execution via `MultiThreadedExecutor(num_threads=2)` and `ReentrantCallbackGroup`.
   - Decodes 36-byte binary telemetry at 50 Hz and encodes 12-byte velocity targets with CRC-16-CCITT.
   - Computes Runge-Kutta 2nd-order odometry and broadcasts `odom` $	o$ `base_footprint` TF transforms.
   - Publishes `/odom`, `/joint_states`, `/nammy/battery`, and `/sonar/range_[0..3]`.

2. **[`nammy_motors`](src/nammy_motors):**
   - Intercepts raw `/cmd_vel` from Nav2 or teleop and enforces physical robot dynamics limits.
   - Independent slew rate limiters for linear acceleration ($0.8	ext{ m/s}^2$) and angular acceleration ($1.5	ext{ rad/s}^2$).
   - Monitors motor health and coordinates software emergency stops.

3. **[`nammy_imu`](src/nammy_imu):**
   - Direct Linux hardware I2C driver for the Bosch BNO055 9-DOF sensor on Jetson I2C Bus 7 (`/dev/i2c-7`).
   - Reads fused orientation quaternions, angular velocities, and linear accelerations at 100 Hz.
   - Publishes standard `sensor_msgs/msg/Imu` and `sensor_msgs/msg/MagneticField` with calibrated covariance matrices.

4. **[`nammy_power`](src/nammy_power):**
   - Subscribes to `/nammy/battery` and performs state-of-charge (SOC) estimation using an 8S LiFePO4 discharge curve.
   - Publishes `sensor_msgs/msg/BatteryState` and emits critical audio/visual alerts when voltage drops below 20.0V.

5. **[`nammy_display`](src/nammy_display):**
   - Production PyQt6 touch interface designed for the robot's physical 10.1" (1280x800) capacitive screen.
   - Real-time battery gauge, live speedometers, sonar distance radar visualizer, and one-touch emergency stop.

6. **[`nammy_teleop`](src/nammy_teleop):**
   - Terminal keyboard driving engine supporting WASD, IJKL, and arrow keys.
   - Features a **0.25-second auto-stop deadman timer** with smooth deceleration ramping to prevent runaway motion or passenger jerk upon key release.

7. **[`nammy_description`](src/nammy_description):**
   - Complete kinematic URDF and Xacro definitions of the chassis, wheels, caster, sensors, and payload bay.
   - Custom RViz configurations: [`view_robot.rviz`](src/nammy_description/rviz/view_robot.rviz) and [`mapping.rviz`](src/nammy_description/rviz/mapping.rviz).

8. **[`nammy_bringup`](src/nammy_bringup):**
   - Umbrella launch orchestrators:
     - [`robot.launch.py`](src/nammy_bringup/launch/robot.launch.py): Launches base hardware, IMU, sonars, and LiDAR.
     - [`mapping.launch.py`](src/nammy_bringup/launch/mapping.launch.py): Master SLAM mapping orchestrator with delayed SLAM Toolbox and RViz2.
     - [`dashboard.launch.py`](src/nammy_bringup/launch/dashboard.launch.py): Launches the touch HMI dashboard.

9. **[`nammy_sonar`](src/nammy_sonar):**
   - Subscribes to 4x US-100 range topics, applies outlier filtering, and projects acoustic cones into a 3D `sensor_msgs/msg/PointCloud2` for Nav2 obstacle avoidance.

10. **[`nammy_lidar`](src/nammy_lidar):**
    - High-speed driver for YDLIDAR G2 at 230,400 baud.
    - Includes simulation fallback node generating synthetic 360° scans when hardware is offline.

---
## 11. End-to-End Installation & Setup Walkthrough (From Scratch)

Follow this step-by-step procedure to deploy the software stack on an NVIDIA Jetson Orin Nano Super or Ubuntu 22.04 development workstation:

### Step 1: System Prerequisites & Base Dependencies

Ensure ROS 2 Humble Hawksbill is installed:
```bash
sudo apt update && sudo apt install -y \
    build-essential \
    cmake \
    python3-pip \
    python3-dev \
    python3-venv \
    python3-colcon-common-extensions \
    python3-rosdep \
    i2c-tools \
    libi2c-dev \
    ros-humble-desktop \
    ros-humble-slam-toolbox \
    ros-humble-robot-localization \
    ros-humble-teleop-twist-keyboard \
    ros-humble-nav2-map-server \
    git
```

### Step 2: Clone the Repository

Clone the repository to `/home/comppoint/Documents/nammy_ws`:
```bash
mkdir -p /home/comppoint/Documents
cd /home/comppoint/Documents
git clone https://github.com/namanharshwal/Hotel_Serving_Robot.git nammy_ws
cd nammy_ws
ln -sf /home/comppoint/Documents/nammy_ws /home/comppoint/nammy_ws
```

### Step 3: Isolated Python Virtual Environment & Requirements

Set up a dedicated virtual environment with system site package access:
```bash
python3 -m venv --system-site-packages .venv
source .venv/bin/activate
pip install --upgrade pip setuptools wheel
pip install -r requirements.txt
```

### Step 4: Hardware Udev Rules Installation

Install udev rules to guarantee persistent symlinks for USB peripherals:
```bash
sudo cp scripts/udev/99-nammy-robot.rules /etc/udev/rules.d/
sudo udevadm control --reload-rules && sudo udevadm trigger
sudo usermod -a -G dialout,i2c $USER
```
*Log out and log back in for group permissions to take effect.*

### Step 5: PlatformIO Firmware Compilation & Flashing

Compile and upload the deterministic real-time firmware to the ESP32-S3:
```bash
cd /home/comppoint/Documents/nammy_ws/firmware/esp32s3_smartelex_driver
pio run -t upload --upload-port /dev/ttyACM0
cd /home/comppoint/Documents/nammy_ws
```

### Step 6: ROS 2 Workspace Build

Build all 10 ROS 2 packages using symlink installation:
```bash
source /opt/ros/humble/setup.bash
source .venv/bin/activate
colcon build --symlink-install --cmake-args -DCMAKE_BUILD_TYPE=Release
```

### Step 7: Workspace Environment Activation

Every terminal session interacting with the robot must activate the unified environment:
```bash
source /home/comppoint/Documents/nammy_ws/activate_nammy.sh
```
This automatically sets `ROS_DOMAIN_ID=42`, activates the `.venv`, sources ROS 2 Humble, and configures handy command aliases.

---
## 12. Pre-Flight Hardware Diagnostics & Verification Suite

Before operating the robot, verify each physical subsystem independently using our standalone diagnostic tools:

### Diagnostic 1: ESP32 Hardware Mediator Interactive Test
Run the comprehensive test utility:
```bash
source /home/comppoint/Documents/nammy_ws/activate_nammy.sh
python3 /home/comppoint/Documents/nammy_ws/scripts/esp32_mediator_test.py /dev/ttyACM0
```
Interactive diagnostic menu options:
* **`[1] Live Telemetry Stream:`** Decodes encoder ticks, wheel angular velocities ($	ext{rad/s}$), 24V battery voltage, and status flags.
* **`[2] Velocity Step Test:`** Drives wheels forward at 2.0 rad/s under closed-loop PID control.
* **`[3] Differential Turn Test:`** Spins robot in place to verify opposing wheel rotation and coordinate frames.
* **`[4] Open-Loop PWM Calibration:`** Sweeps PWM duty cycle (-1023 to +1023) to measure motor deadband.
* **`[5] Live PID Gain Tuning:`** Adjusts $K_p$, $K_i$, $K_d$, and $K_{ff}$ in runtime RAM.
* **`[6] Emergency Stop:`** Instantly cuts motor PWM to zero.
* **`[7] Live Sonar Range Stream:`** Real-time distance readings for Front, Left, Right, and Rear US-100 sonars + reflex emergency stop flags.

### Diagnostic 2: Motor Polarity & Direction Verification
```bash
python3 /home/comppoint/Documents/nammy_ws/scripts/motor_test.py /dev/nammy_esp32
```
*Elevate robot wheels off the ground before executing this test.*

### Diagnostic 3: High-Speed Serial Throughput & Jitter Benchmark
```bash
python3 /home/comppoint/Documents/nammy_ws/scripts/esp32_serial_benchmark.py
```
Measures packet loss, CRC error rates, and round-trip latency at 115,200 baud over 10,000 packets.

### Diagnostic 4: I2C Bus Scan for Bosch BNO055 IMU
Verify the BNO055 is detected on Jetson I2C bus 7 at address `0x28`:
```bash
i2cdetect -y -r 7
```
*(Look for `28` in the output matrix).*

### Diagnostic 5: Physical LiDAR Serial & Turret Rotation Verification
Verify that the YDLIDAR G2 is enumerating on USB and that its turret is spinning:
```bash
ls -la /dev/ydlidar
# Verify raw serial data stream:
picocom -b 230400 /dev/ydlidar
```
*(Binary data should stream across the terminal once the turret is physically rotating).*

### Diagnostic 6: SLAM Toolbox Scan & TF Continuity Check
Verify transform tree continuity from `map` to `laser_frame`:
```bash
ros2 run tf2_ros tf2_echo map base_footprint
ros2 topic hz /scan
```

---
## 13. Launching the Full Autonomous Stack & Operation Runbooks

### Runbook 1: Primary Master Robot Hardware Bringup
Launch all core hardware nodes (ESP32 bridge, odometry, robot_state_publisher, IMU driver, Sonar fusion, and LiDAR):
```bash
source /home/comppoint/Documents/nammy_ws/activate_nammy.sh
ros2 launch nammy_bringup robot.launch.py serial_port:=/dev/ttyACM0
```
*(If the physical YDLIDAR G2 is not connected, append `simulate_lidar:=true` to run the simulation fallback node).*

---

### Runbook 2: Full Autonomous SLAM Mapping Bringup
Launch the complete SLAM Toolbox online async mapping stack with automatic $4.0	ext{ s}$ sequencing delay and custom RViz2 visualization:
```bash
source /home/comppoint/Documents/nammy_ws/activate_nammy.sh
ros2 launch nammy_bringup mapping.launch.py rviz:=true
```
*(For offline desk verification without physical LiDAR, append `simulate_lidar:=true`).*

---

### Runbook 3: Physical Manual Robot Control (Zero Simulation, Zero RViz)
For pure physical manual robot movement without launching any simulations, RViz, Nav2, or SLAM:

**Option A: In-Terminal Direct Control (Fastest, Recommended)**
```bash
# Sourced automatically in any terminal, or run:
source ~/Documents/nammy_ws/activate_nammy.sh
nammy_manual
```
*(Or directly: `bash ~/Documents/nammy_ws/scripts/manual_teleop.sh`)*

**Option B: Desktop GUI Launcher (Opens Teleop xterm Window)**
```bash
nammy_manual_gui
# Or:
ros2 launch nammy_bringup manual_teleop.launch.py
```

* **Controls:**
  - **Drive:** Hold `w` / `i` (Forward), `s` / `,` (Reverse), `a` / `j` (Turn Left), `d` / `l` (Turn Right).
  - **Speed Presets:** Press `1` (Crawl 0.05 m/s), `2` (Slow 0.12 m/s), `3` (Normal 0.20 m/s), `4` (Brisk 0.32 m/s), `5` (Fast 0.45 m/s).
  - **Auto-Stop Deadman:** Release the key $\rightarrow$ robot automatically decelerates smoothly to exact $0.000\text{ m/s}$.
  - **Fine-Tuning:** `q` / `+` (Increase $+0.02\text{ m/s}$), `z` / `-` (Decrease $-0.02\text{ m/s}$).
  - **Emergency Brake:** Press `Space` or `x` / `k`.

---

### Runbook 4: Saving the Generated Occupancy Grid Map
Once you have mapped the floor plan, save the map files (`.yaml` and `.pgm`) in a separate terminal:
```bash
source /home/comppoint/Documents/nammy_ws/activate_nammy.sh
mkdir -p /home/comppoint/Documents/nammy_ws/maps
ros2 run nav2_map_server map_saver_cli -f /home/comppoint/Documents/nammy_ws/maps/hotel_floor1
```

---

### Runbook 5: 10.1" Capacitive Touch HMI Dashboard
On the robot's physical display:
```bash
source /home/comppoint/Documents/nammy_ws/activate_nammy.sh
ros2 launch nammy_bringup dashboard.launch.py
```

---

### Runbook 6: Complete TF & 3D Visualization in RViz2
To inspect the complete 3D kinematic model and live TF transforms:
```bash
source /home/comppoint/Documents/nammy_ws/activate_nammy.sh
ros2 launch nammy_description view_robot.launch.py
```

---
## 14. Multi-Tier Safety Systems & Reflex Braking

Safety in hospitality environments is paramount. Nammy Robot features a **four-layer redundant safety architecture**:

1. **Autonomous Hardware Reflex Braking (< 10 ms):**
   The ESP32-S3 continuously monitors the 4x US-100 ultrasonic array. If an obstacle (e.g., child, glass door, fallen luggage) is detected closer than **15 cm** in the direction of travel, the microcontroller instantly forces both SmartElex PWM channels to zero in **< 10 ms**, completely bypassing any potential Jetson OS or ROS 2 latency.
2. **Communications Hardware Watchdog (600 ms):**
   The ESP32 firmware includes a 600 ms countdown timer reset by every incoming `/cmd_vel` packet. If ROS 2 crashes, the Jetson locks up, or the USB cable is severed, the watchdog expires and halts the motors immediately.
3. **Teleoperation Auto-Stop Deadman Timer (250 ms):**
   Keyboard teleop automatically resets setpoints to zero when key inputs cease for longer than $250	ext{ ms}$, ensuring the robot never runs away if an operator releases their controls.
4. **24V LiFePO4 Undervoltage Protection (20.0V Cutoff):**
   The ADC continuously samples battery voltage. When pack voltage drops below 20.0V (2.50V/cell), the hardware bridge disables motor drive commands and issues critical diagnostic alarms to prevent cell reversal.
5. **Physical E-Stop & Software E-Stop:**
   A high-visibility physical mushroom emergency stop switch physically disconnects the 24V battery line, while a prominent red touch button on the 10.1" dashboard broadcasts `/nammy/estop`.

---
## 15. Enterprise Security Architecture & System Hardening

### 15.1 SROS2 & DDS-Security Specification (PKI & Wire Encryption)

The robot implements full **SROS2 (Secure Robot Operating System 2)** cryptographic authentication and wire encryption:
* **PKI Authentication:** Every ROS 2 node possesses an X.509 identity certificate signed by an isolated Certificate Authority (`CA`).
* **Access Control:** Signed XML governance documents restrict topic publishing/subscribing permissions.
* **Wire Encryption:** Real-time DDS wire encryption via AES-GCM-256 prevents topic eavesdropping or packet injection on shared enterprise Wi-Fi networks.

### 15.2 Linux Host & Network Hardening (UFW & Sysctl)

The NVIDIA Jetson Orin Nano Super host OS is hardened using strict kernel sysctl policies and firewall rules:
* Uncomplicated Firewall (UFW) default-deny incoming policy.
* Disabled IPv6 source routing and ICMP redirects.
* Kernel SYN flood cookies and reverse path filtering (`rp_filter = 1`) enabled.

### 15.3 Real-Time Hardware & Firmware Hardening

* Dual-stage CRC-16 checksum verification on all USB serial packets.
* Hardware watchdog timer (WDT) on ESP32-S3 Core 0 and Core 1.
* Non-volatile wear-leveling EEPROM parameter storage.

### 15.4 Automated Static Security Audit Tool

Verify system hardening anytime using our custom automated security tool:
```bash
python3 scripts/security_audit.py
```

---
## 16. Troubleshooting & Frequently Asked Questions (FAQ)

### Q1: Why do the motors jerk or shudder at low speeds, or fail to move until high throttle?
**Cause:** The motor driver's PWM frequency is set too high (e.g., 20 kHz). The SmartElex 30S uses optical isolators on its inputs with rise/fall times of $2.5	ext{–}4.0\ \mu	ext{s}$. At 20 kHz (period $50\ \mu	ext{s}$), narrow pulses get rounded or filtered out, creating a massive deadband (~15–20%). When the PID winds up to overcome the deadband, the driver suddenly activates with violent torque.  
**Solution:** Ensure the ESP32 firmware uses **490 Hz PWM** (`_freq = 490` in `SmartElex30S.cpp`). At 490 Hz (period $2040.8\ \mu	ext{s}$), the optocoupler switches cleanly down to 1% duty, delivering sub-millimeter smooth velocity.

### Q2: Why did the robot keep moving or rotating after releasing keyboard teleop keys?
**Cause:** Standard ROS teleop nodes latch the last commanded velocity until a new key is pressed. If network latency delays the stop command, the robot continues moving.  
**Solution:** Use [`nammy_teleop/teleop_keyboard.py`](src/nammy_teleop/nammy_teleop/teleop_keyboard.py), which implements an automatic **0.25-second deadman safety timer** that actively ramps target velocity down to $0.000	ext{ m/s}$ as soon as key presses stop.

### Q3: Why is the YDLIDAR G2 not producing laser scans even though `/dev/ttyUSB0` is detected?
**Cause:** The circular turret on the LiDAR is physically **not rotating**. The YDLIDAR G2 internal MCU features an optical safety interlock: if the brushless turret motor is stationary, the laser diode will not fire and the MCU will not transmit health packets or scan packets (returning 0 bytes and `Failed to start scan mode -1`).  
**Solution:**
1. Connect auxiliary **5V power (~400–500 mA)** to the Micro-USB port or DC terminals on the LiDAR adapter board. (The main USB cable only powers the CP2102 data bridge).
2. Check that the small flexible flat ribbon cable between the adapter board and rotating base is firmly seated.
3. Verify that the turret spins freely by hand with zero mechanical friction.

### Q4: How do I test SLAM mapping if the physical LiDAR is disconnected or undergoing maintenance?
**Solution:** Append `simulate_lidar:=true` to the mapping launch command:
```bash
ros2 launch nammy_bringup mapping.launch.py simulate_lidar:=true
```
This generates synthetic 360° laser scans at 10 Hz, fully validating the SLAM Toolbox pose graph and RViz occupancy grid without hardware.

### Q5: Permission denied when accessing `/dev/ttyACM0` or `/dev/ttyUSB0`.
**Solution:** Add your Linux user to the `dialout` group and reload udev:
```bash
sudo usermod -a -G dialout,i2c $USER
sudo udevadm control --reload-rules && sudo udevadm trigger
```
*Log out and log back in for changes to apply.*

### Q6: Ultrasonic sensors report 0.0m or maximum distance.
**Solution:** Ensure the US-100 sensor jumpers are **removed** (setting the sensors to GPIO Trigger/Echo mode rather than Serial UART mode), and verify that the TXS0108E high-side supply (`VCCB`) is receiving 5.1V.

---
## 17. Authorship & Intellectual Property Notice

* **Project Architect, Author & Sole Copyright Holder:** Naman Harshwal  
* **Official Contact:** [namanharshwal@gmail.com](mailto:namanharshwal@gmail.com)  
* **GitHub Repository:** [https://github.com/namanharshwal/Hotel_Serving_Robot](https://github.com/namanharshwal/Hotel_Serving_Robot)  
* **Copyright Notice:** © 2025–2026 Naman Harshwal. All Rights Reserved.  
* **Software License:** Licensed under the Apache License, Version 2.0. You may obtain a copy of the License in the [`LICENSE`](LICENSE) file.  

---
