namanharshwal/Hotel_Serving_Robot/src/nammy_description/meshes/back_castor.STL

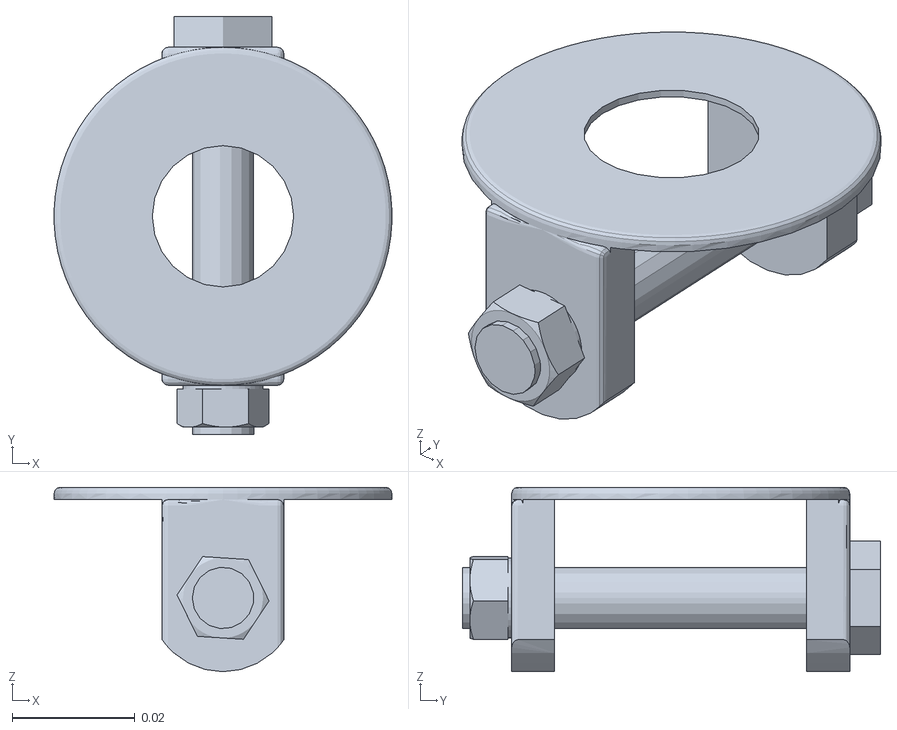
[picture p1: CAD file, 2026-11-04]
src/nammy_description/meshes/back_castor.STL
0.055 x 0.068 x 0.03
