namanharshwal/Hotel_Serving_Robot/src/nammy_description/meshes/base_link.STL

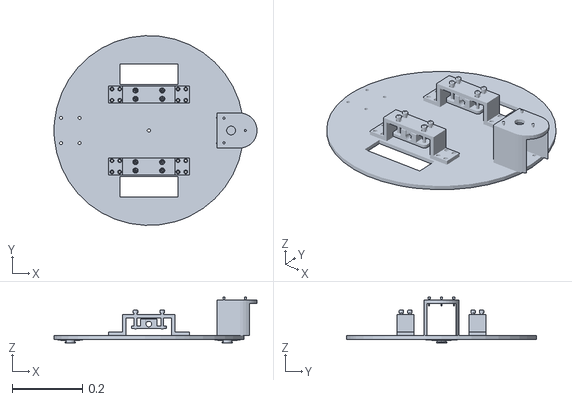
[picture p2: CAD file, 2026-11-04]
src/nammy_description/meshes/base_link.STL
0.577 x 0.54 x 0.13
