namanharshwal/Hotel_Serving_Robot/src/nammy_description/meshes/back_wheel.STL

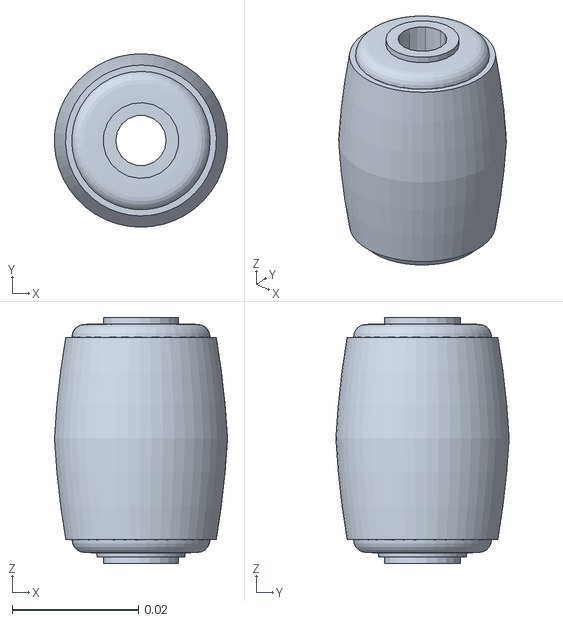
[picture p3: CAD file, 2026-11-04]
src/nammy_description/meshes/back_wheel.STL
0.0275 x 0.0275 x 0.039
