namanharshwal/Hotel_Serving_Robot/src/nammy_description/meshes/lidar_sensor.STL

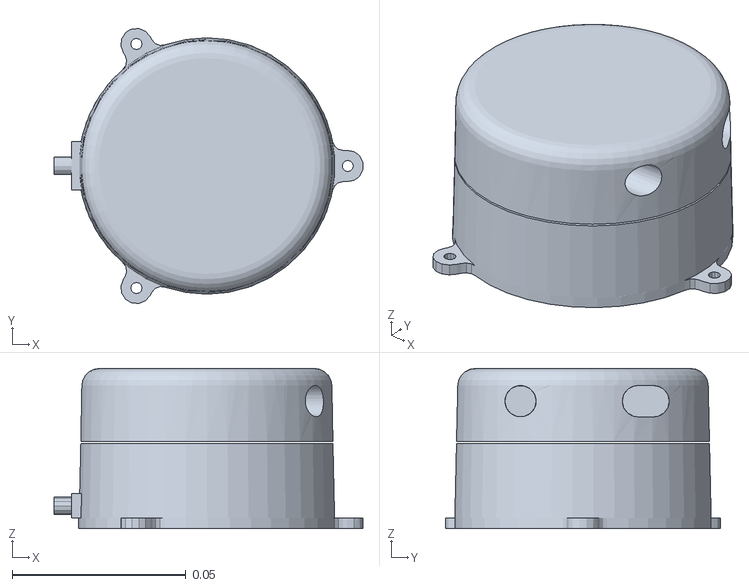
[picture p4: CAD file, 2026-11-04]
src/nammy_description/meshes/lidar_sensor.STL
0.0888 x 0.079 x 0.046
