namanharshwal/Hotel_Serving_Robot/src/nammy_description/meshes/left_wheel.STL

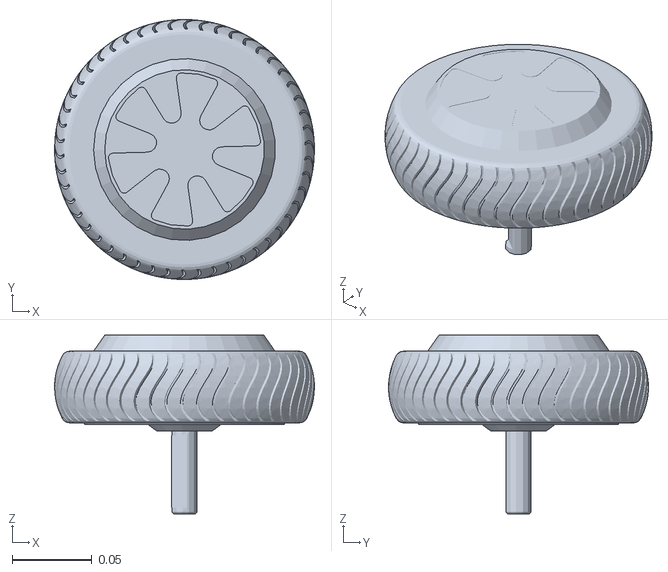
[picture p5: CAD file, 2026-11-04]
src/nammy_description/meshes/left_wheel.STL
0.163 x 0.163 x 0.112
