namanharshwal/Hotel_Serving_Robot/(list of files, cad)

Other CAD files:
src/nammy_description/meshes/front_wheel.STL
src/nammy_description/meshes/right_wheel.STL
