namanharshwal/Hotel_Serving_Robot/firmware/esp32s3_smartelex_driver/src/EncoderReader.cpp

#include "EncoderReader.h"

// Canonical 4x quadrature Gray-code transition lookup table:
// Index: (old_state << 2) | new_state where state is (PinA << 1) | PinB
// States: 00 (0), 01 (1), 10 (2), 11 (3)
// Forward:  00 -> 01 -> 11 -> 10 -> 00 (+1)
// Reverse:  00 -> 10 -> 11 -> 01 -> 00 (-1)
static const int8_t QUAD_TABLE[16] = {
    0,  1, -1,  0,
   -1,  0,  0,  1,
    1,  0,  0, -1,
    0, -1,  1,  0
};

EncoderReader::EncoderReader(uint8_t pin_a, uint8_t pin_b, bool inverted)
    : _pin_a(pin_a), _pin_b(pin_b), _inverted(inverted), _last_state(0),
      _ticks(0), _prev_ticks(0),
      _position_rad(0.0f), _velocity_rad_s(0.0f),
      _distance_m(0.0f), _linear_vel_m_s(0.0f) {}

void EncoderReader::begin() {
    pinMode(_pin_a, INPUT_PULLUP);
    pinMode(_pin_b, INPUT_PULLUP);
    uint8_t a = digitalRead(_pin_a) ? 1 : 0;
    uint8_t b = digitalRead(_pin_b) ? 1 : 0;
    _last_state = (a << 1) | b;
    reset();
}

void IRAM_ATTR EncoderReader::handleISR() {
    uint8_t a = digitalRead(_pin_a) ? 1 : 0;
    uint8_t b = digitalRead(_pin_b) ? 1 : 0;
    uint8_t curr = (a << 1) | b;
    int8_t delta = QUAD_TABLE[((_last_state & 0x03) << 2) | (curr & 0x03)];
    _last_state = curr;
    if (delta != 0) {
        if (_inverted) {
            delta = -delta;
        }
        _ticks += delta;
    }
}

void EncoderReader::update(float dt) {
    if (dt <= 0.0f) return;

    // Atomically sample volatile ticks
    noInterrupts();
    int64_t current_ticks = _ticks;
    interrupts();

    int64_t delta_ticks = current_ticks - _prev_ticks;
    _prev_ticks = current_ticks;

    // Angle and distance
    _position_rad = ((float)current_ticks / TICKS_PER_WHEEL_REV) * TWO_PI_F;
    _distance_m = _position_rad * WHEEL_RADIUS_METERS;

    // Instantaneous angular velocity (rad/s)
    float raw_vel_rad_s = ((float)delta_ticks / TICKS_PER_WHEEL_REV) * TWO_PI_F / dt;

    // 1st-order Low-Pass Filter (alpha = 0.70) for responsive feedback (<10ms lag)
    // Minimizes closed-loop phase delay while preserving optical encoder smoothness
    _velocity_rad_s = (0.30f * _velocity_rad_s) + (0.70f * raw_vel_rad_s);
    _linear_vel_m_s = _velocity_rad_s * WHEEL_RADIUS_METERS;
}

int64_t EncoderReader::getTicks() const {
    return _ticks;
}

float EncoderReader::getPositionRad() const {
    return _position_rad;
}

float EncoderReader::getDistanceMeters() const {
    return _distance_m;
}

float EncoderReader::getVelocityRadS() const {
    return _velocity_rad_s;
}

float EncoderReader::getLinearVelocityMs() const {
    return _linear_vel_m_s;
}

void EncoderReader::reset() {
    noInterrupts();
    _ticks = 0;
    interrupts();
    _prev_ticks = 0;
    _position_rad = 0.0f;
    _velocity_rad_s = 0.0f;
    _distance_m = 0.0f;
    _linear_vel_m_s = 0.0f;
}
