namanharshwal/Hotel_Serving_Robot/src/nammy_bringup/config/robot_params.yaml

# ==============================================================================
# NAMMY ROBOT - MASTER COMPONENT PARAMETERS
# Components:
#   - nammy_base   : ESP32-S3 Hardware Bridge & Differential Drive Odometry
#   - nammy_motors : SmartElex 30S Dual Drivers & AT120 Otis DC Gear Motors
#   - nammy_imu    : Bosch BNO055 9-DOF Absolute Orientation IMU
#   - nammy_power  : 24V 15Ah LiFePO4 (LFP) 8S Battery Subsystem
# ==============================================================================

# 1. Base Motion & Serial Mediator (nammy_base)
esp32_hardware_bridge:
  ros__parameters:
    serial_port: "/dev/nammy_esp32"
    baud_rate: 115200
    publish_rate: 50.0  # Hz

    wheel_radius: 0.050        # 100mm Heavy Duty Disc Wheel (r = 50mm)
    wheel_separation: 0.380    # Track width: 380mm

    odom_frame_id: "odom"
    base_frame_id: "base_footprint"
    publish_tf: true

    cmd_timeout: 1.00          # Seconds before safety stopping motors (resilient to DDS jitter)
    simulate_hardware: false   # Auto-fallback to simulation if USB serial disconnected
    max_linear_velocity: 1.2   # Max linear velocity (m/s)
    max_angular_velocity: 2.5  # Max angular velocity (rad/s)
    max_linear_acceleration: 4.0   # Snappy real-time instant linear response (4.0 m/s^2)
    max_angular_acceleration: 8.0  # Snappy real-time instant angular response (8.0 rad/s^2)
    invert_encoders: false         # Forward physical travel generates positive +X odometry displacement

    # Active IMU Heading Stabilization & Dual Motor RPM Synchronization
    enable_imu_heading_hold: true  # Closed-loop BNO055 heading hold for zero straight-line drift
    heading_kp: 2.2                # Heading error proportional gain (rad/s per rad)
    heading_ki: 0.08               # Heading error integral gain
    heading_kd: 0.15               # Gyroscopic rate damping gain (rad/s per rad/s)
    max_heading_correction: 0.60   # Maximum angular velocity correction trim (rad/s)
    enable_rpm_sync: true          # Dual motor speed cross-coupling equalizer
    rpm_sync_kp: 0.25              # Wheel speed error proportional gain
    rpm_sync_ki: 0.04              # Wheel speed error integral gain
    straight_lin_threshold: 0.01   # Min linear speed to activate heading lock (m/s)
    straight_ang_threshold: 0.05   # Max angular command considered straight motion (rad/s)

# 2. SmartElex 30S & AT120 Motor Manager (nammy_motors)
motor_manager:
  ros__parameters:
    max_wheel_rpm: 200.0       # AT120 rated speed ~200 RPM
    gear_ratio: 15.0           # 15:1 integrated planetary gearbox
    continuous_current_a: 30.0 # SmartElex 30S continuous rating
    peak_current_a: 85.0       # Peak 85A
    deadband_compensation: 60  # Overcomes initial static friction

# 3. Bosch BNO055 9-DOF IMU (nammy_imu)
bno055_node:
  ros__parameters:
    i2c_bus: 7                 # Jetson 40-pin header Pin 27 (SDA) & Pin 28 (SCL) -> /dev/i2c-7
    i2c_address: 40            # 0x28 in decimal (0x28 = 40)
    frame_id: "imu_link"
    publish_rate: 100.0        # 100 Hz matching hover_ws
    simulate_hardware: false

# 4. 24V 15Ah LiFePO4 Power Subsystem (nammy_power)
battery_monitor_node:
  ros__parameters:
    nominal_voltage: 25.6      # 8S LiFePO4 (8 * 3.2V)
    cells_series: 8
    capacity_ah: 15.0          # 15 Ah (384 Wh)
    low_voltage_threshold: 21.6
    critical_voltage_threshold: 20.0

# 5. 4x US-100 Ultrasonic Array & Costmap Fusion (nammy_sonar)
sonar_fusion_node:
  ros__parameters:
    base_frame: "base_link"
    critical_stop_distance: 0.15   # 15 cm
    max_detection_range: 3.50      # 3.5 m
    points_per_cone: 5
