namanharshwal/Hotel_Serving_Robot/src/nammy_lidar/config/ydlidar_g2_params.yaml

# ==============================================================================
# YDLIDAR G2 Driver Parameters for Nammy Robot Platform
# Configured and validated from proven hover_ws production configuration
#
# Maintainer: Naman Harshwal <namanharshwal@gmail.com>
# Copyright (c) 2026 Naman Harshwal. All rights reserved.
# ==============================================================================

/**:
  ros__parameters:
    port: /dev/ydlidar          # Symlinked from /dev/ttyUSB0 (CP2102)
    frame_id: laser_frame       # Matches nammy_robot.urdf.xacro laser_frame link
    ignore_array: ""            # Full 360-degree panoramic field of view
    baudrate: 230400            # YDLIDAR G2 standard baud rate
    lidar_type: 1               # Triangulation LiDAR (G2 variant)
    device_type: 6              # 6 = YDLIDAR G2 / X4 DTR motor control
    isSingleChannel: false      # Multi-beam bi-directional communication
    intensity: false            # High-speed range mapping without intensity overhead
    intensity_bit: 0
    sample_rate: 9              # ~2880 points/revolution
    abnormal_check_count: 4
    fixed_resolution: true      # Consistent angular resolution across scans
    reversion: true             # 180-degree hardware offset alignment for YDLIDAR G2
    inverted: true              # Upright top chassis mounting orientation
    auto_reconnect: true        # Automatic serial port recovery upon glitch
    support_motor_dtr: true     # Enable DTR line to start/stop the spinning motor
    angle_max: 90.0             # Front 180-degree scan (+90.0 deg / left boundary)
    angle_min: -90.0            # Front 180-degree scan (-90.0 deg / right boundary)
    range_max: 12.0             # 12.0m max range limit
    range_min: 0.12             # 12cm minimum range cutoff
    frequency: 10.0             # 10.0 Hz scan rotation frequency
    invalid_range_is_inf: false # Return 0 for out-of-range (SLAM preferred)
    debug: false                # Non-verbose driver logging

    # QoS Profile tuned for real-time laser scan delivery to SLAM & RViz
    qos_overrides:
      /scan:
        reliability: reliable
        history: keep_last
        depth: 10
        durability: volatile
