namanharshwal/Hotel_Serving_Robot/(commit log)

2026-11-02 feat: complete isolated setup for Nammy Robot (ROS 2 Humble + ESP32-S3 mediator + SmartElex 30S)
    [nammy_robot.urdf.xacro, robot_params.yaml]
2026-11-03 feat: add 4-channel US-100 ultrasonic array, TXS0108E level shifter, and YDLIDAR G2 support
    [nammy_robot.urdf.xacro, robot_params.yaml]
2026-11-03 docs: update README with complete US-100 ultrasonic array, TXS0108E wiring, YDLIDAR G2, and diagnostic guide
2026-11-04 feat(description): integrate SolidWorks CAD URDF kinematic model and binary meshes
    - Port full SolidWorks 3D CAD STL meshes (base_link, left_wheel, right_wheel, front_castor, front_wheel, back_castor, back_wheel, lidar_sensor)
    - Incorporate exact SolidWorks physical masses, centers of gravity, and 3D inertia tensors
    - Preserve SolidWorks continuous drive joint axes (ltwheeljt, rtwheeljt) with dual-alias joint_state broadcasting in esp32_hardware_bridge
    - Maintain complete sensor array (base_footprint, imu_link, laser_frame, 4x US-100 ultrasonic range frames, 10.1 inch touch display)
    - Add RViz2 view_robot.rviz display scene and update README.md documentation
    - Sole Copyright (c) 2025-2026 Na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
    [back_castor.STL, back_wheel.STL, base_link.STL, front_castor.STL, front_wheel.STL, left_wheel.STL, lidar_sensor.STL, nammy_robot.urdf.xacro]
2026-11-05 fix(udev): add Waveshare vendor ID 0712:000a and case matching to touch rules
2026-11-05 fix(bridge): auto-probe ESP32 telemetry signature on serial ports and default to hardware UART
    [esp32_hardware_bridge.py]
2026-11-05 fix(base,power): initialize max velocity bounds and throttle battery alert logging
    [robot_params.yaml]
2026-11-05 fix(firmware): implement 4x quadrature Gray decoding and correct encoder polarity for closed-loop motion
    [EncoderReader.cpp, EncoderReader.h, SmartElex30S.cpp, main.cpp]
2026-11-05 fix(bringup,rviz): auto-detect serial port and configure odom fixed frame with odometry display
2026-11-05 fix(control): eliminate jerky motion with Core 0 sonar task, smooth deadband blend, PI tuning, and teleop accel ramp
    [EncoderReader.cpp, SmartElex30S.cpp, VelocityPID.cpp, main.cpp]
2026-11-05 fix(control): set 490Hz PWM for SmartElex 30S, unidirectional quadrant control, and deadman release stop
    [SmartElex30S.cpp, SmartElex30S.h, main.cpp]
2026-11-05 fix(control): set 490Hz PWM, 600ms watchdog, Kff=49.0, deadman release stop, and smooth slew rate
    [robot_params.yaml]
2026-11-05 fix(control): remove binary stream ASCII parser, tune Kff=28 with bounded anti-windup for ultra-smooth velocity
    [PacketProtocol.cpp, SmartElex30S.cpp, VelocityPID.cpp, main.cpp]
2026-11-05 fix(bridge): use MultiThreadedExecutor and 1.0s cmd_timeout to prevent thread starvation
    [robot_params.yaml]
2026-11-05 feat(slam): Port proven hover_ws LiDAR and SLAM Toolbox mapping stack to nammy_ws
    - Update ydlidar_g2_params.yaml to match proven hover_ws settings (port: /dev/ydlidar, frame_id: laser_frame, baud: 230400, device_type: 0, support_motor_dtr: false, QoS best-effort).
    - Add slam_toolbox_params.yaml ported from hover_ws online asynchronous mapping configuration.
    - Add mapping.launch.py sequencing ESP32 bringup, YDLIDAR driver, and delayed async_slam_toolbox_node.
    - Add mapping.rviz and update view_robot.rviz to visualize live /map occupancy grid and /scan alongside odometry and URDF TF tree.
    - Update lidar_sim_fallback.py to use laser_frame link matching URDF specification.
2026-11-05 docs: Update comprehensive README with motor control derivations, firmware architecture, and SLAM mapping guide
2026-11-05 fix(control): eliminate teleop & motor jerkiness via low-lag filtering, calibrated feedforward, and setpoint profiling
    - Firmware (ESP32-S3):
    * Calibrated physical feedforward Kff = 35.0 counts/(rad/s) from open-loop empirical sweep
    * Reduced encoder IIR velocity filter phase lag (alpha 0.18 -> 0.70, settling 167ms -> 43ms)
    * Implemented smooth setpoint acceleration profiling (10.0 rad/s^2 limit)
    * Softened deceleration via setPwmRaw(0) under 800 counts/s slew rate (preventing abrupt cutoff)
    * Scaled velocity PID gains to Kp=2.5, Ki=1.2, Kd=0.0 with 120.0 count integrator headroom
    - Teleop (nammy_teleop):
    * Upgraded teleop_keyboard with Dual Operational Modes (Latched Cruise vs D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
    [EncoderReader.cpp, SmartElex30S.cpp, VelocityPID.cpp, VelocityPID.h, main.cpp]
2026-11-06 feat(vision & slam): integrate Logitech C270 camera driver, URDF optics, and real YDLIDAR G2 mapping
    - Added nammy_camera package with c270_camera_node streaming 640x480 @ 30 FPS to /camera/image_raw
    - Added camera_link and camera_optical_frame to nammy_robot.urdf.xacro
    - Updated RViz configurations (view_robot.rviz and mapping.rviz) with camera image viewer
    - Configured YDLIDAR G2 hardware parameters (device_type: 6, support_motor_dtr: true) for physical scanning
    - Fully integrated into robot.launch.py and mapping.launch.py with Ceres Solver online async SLAM
    [nammy_robot.urdf.xacro]
2026-11-06 feat(nav): integrate BNO055 IMU EKF fusion, autonomous SLAM mapping, and Nav2 stack matching hover_ws
2026-11-06 fix(teleop): remove software ramp lag for instant wheel response, harmonize left/right angular speed with linear travel, and add presets 1-5 for standard SLAM robot velocities
2026-11-06 feat(mapping): auto-detect physical lidar presence and fallback smoothly if disconnected
2026-11-06 fix(lidar): configure Best Effort QoS on lidar fallback to match RViz and SLAM Toolbox
2026-11-06 fix(imu): throttle I2C read error warnings to avoid stdout flooding
    [bno055_node.py]
2026-11-06 fix(imu): configure IMU mode 0x08 matching hover_ws and eliminate fake zero-orientation publication to prevent EKF locking
    [bno055_node.py]
2026-11-06 fix(ekf): enable wheel odometry yaw in EKF and set differential IMU fusion to match hover_ws real-time movement
    [robot_params.yaml]
2026-11-06 fix(imu): configure BNO055 for Jetson 40-pin header Pin 3 (SDA) and Pin 5 (SCL) on /dev/i2c-1 with safe auto-reconnect
    [robot_params.yaml]
2026-11-07 fix(control,camera,lidar): eliminate wheel jerk with S-curve ramp, match turning speeds, fix lidar QoS reliability, and stream C270 HUD
    [bno055_node.py, ydlidar_g2_params.yaml]
2026-11-07 fix(camera,lidar,teleop): disable fake lidar sim, add uvc camera unblacklist script, and tune teleop hold timeout
2026-11-07 feat(teleop, bridge, imu, rviz): integrate bridge slew limiter for smooth wheel motion, add BNO055 header bus auto-detection, fix RViz camera range
    [robot_params.yaml]
2026-11-07 fix(imu): correct BNO055 quaternion conjugate sign for REP-103 ENU rotation, configure EKF IMU master heading authority, and add RViz IMU sensor axes
    [bno055_node.py, ekf.yaml]
2026-11-07 fix(imu): align BNO055 Z-axis yaw and gyro rate so turning left/right strictly matches physical robot motion while keeping forward/backward tilt intact
    [bno055_node.py]
2026-11-07 feat(lidar): restrict laser scanning and SLAM mapping to front 180 degrees (-90 to +90 deg)
2026-11-07 fix(lidar,urdf): enable YDLIDAR G2 hardware reversion and align URDF base footprint joint by pi
    [nammy_robot.urdf.xacro]
2026-11-07 fix(slam,urdf): restore base_footprint_joint forward heading, orient lidar_joint by pi, and add EKF pose topic with 8s SLAM stabilization delay
    [nammy_robot.urdf.xacro]
2026-11-07 fix(bridge): invert encoder feedback polarities to match forward physical travel with RViz ROS odometry
    [esp32_hardware_bridge.py]
2026-11-07 fix(urdf): orient robot model front facing forward in rviz and align lidar joint origin
    [nammy_robot.urdf.xacro]
2026-11-07 perf(bringup): configure snappy 4.0 m/s^2 linear and 8.0 rad/s^2 angular acceleration for instant teleop response
    [robot_params.yaml]
2026-11-07 fix(slam, urdf): resolve rotational map distortion by aligning kinematic frames and tuning scan matching
    [nammy_robot.urdf.xacro]
2026-11-07 fix(imu, ekf, bridge): implement auto-zero heading tare and align forward odometry to eliminate sideways motion
    [nammy_robot.urdf.xacro, robot_params.yaml]
2026-11-07 feat(control): implement active IMU heading stabilization and dual-motor RPM synchronization
    [robot_params.yaml]
2026-11-07 fix(navigation,rviz): eliminate RViz crashes, optimize AMCL wall locking and costmap raytracing
    [ekf.yaml, ydlidar_g2_params.yaml]
2026-11-08 fix(lidar,rviz): synchronize reliable QoS profile across ydlidar driver and rviz
    [ydlidar_g2_params.yaml]
2026-11-08 fix(nav2): add lifecycle bond timeout and stagger node bringup timers
2026-11-08 Fix RViz pink odometry covariance overlay, disable heading hold during Nav2, and implement sequential waypoint navigation
    [ekf.yaml]
2026-11-08 Fix LiDAR 360 degree scan orientation and inverted angular order to keep laser scan static in world frame
    [ydlidar_g2_params.yaml]
2026-11-10 feat(diagnostics): add live 4-channel US-100 ultrasonic verification suite
2026-11-10 feat(sonar): configure 3 front bumper ultrasonic sensors and 1 backside sensor
    [nammy_robot.urdf.xacro]
2026-11-10 fix(mapping): eliminate odometry covariance overlay to prevent pink screen in RViz
2026-11-10 revert: restore proven successful setup from commit fd2e395 (front 180-deg LiDAR, URDF model, and Nav2)
    [nammy_robot.urdf.xacro]
2026-11-10 feat(sonar,mapping): configure 3 front bumper ultrasonics, 1 backside sensor, and unify autonomous SLAM mapping
    [nammy_robot.urdf.xacro]
2026-11-10 feat(teleop,vision): integrate live camera viewer HUD alongside manual teleop
2026-11-10 fix(camera): prevent auto-expanding layout and enable standard minimize/maximize window controls
