namanharshwal/Hotel_Serving_Robot/(notices)

Notices in the files:
README.md:
License: Apache 2.0
https://img.shields.io/badge/Copyright-%C2%A9%202025--2026%20Naman%20Harshwal-blue.svg
